Han-ZenX/CounterCode/hardware/C1804 频率测量模块 (REV04) - SCH.pdf

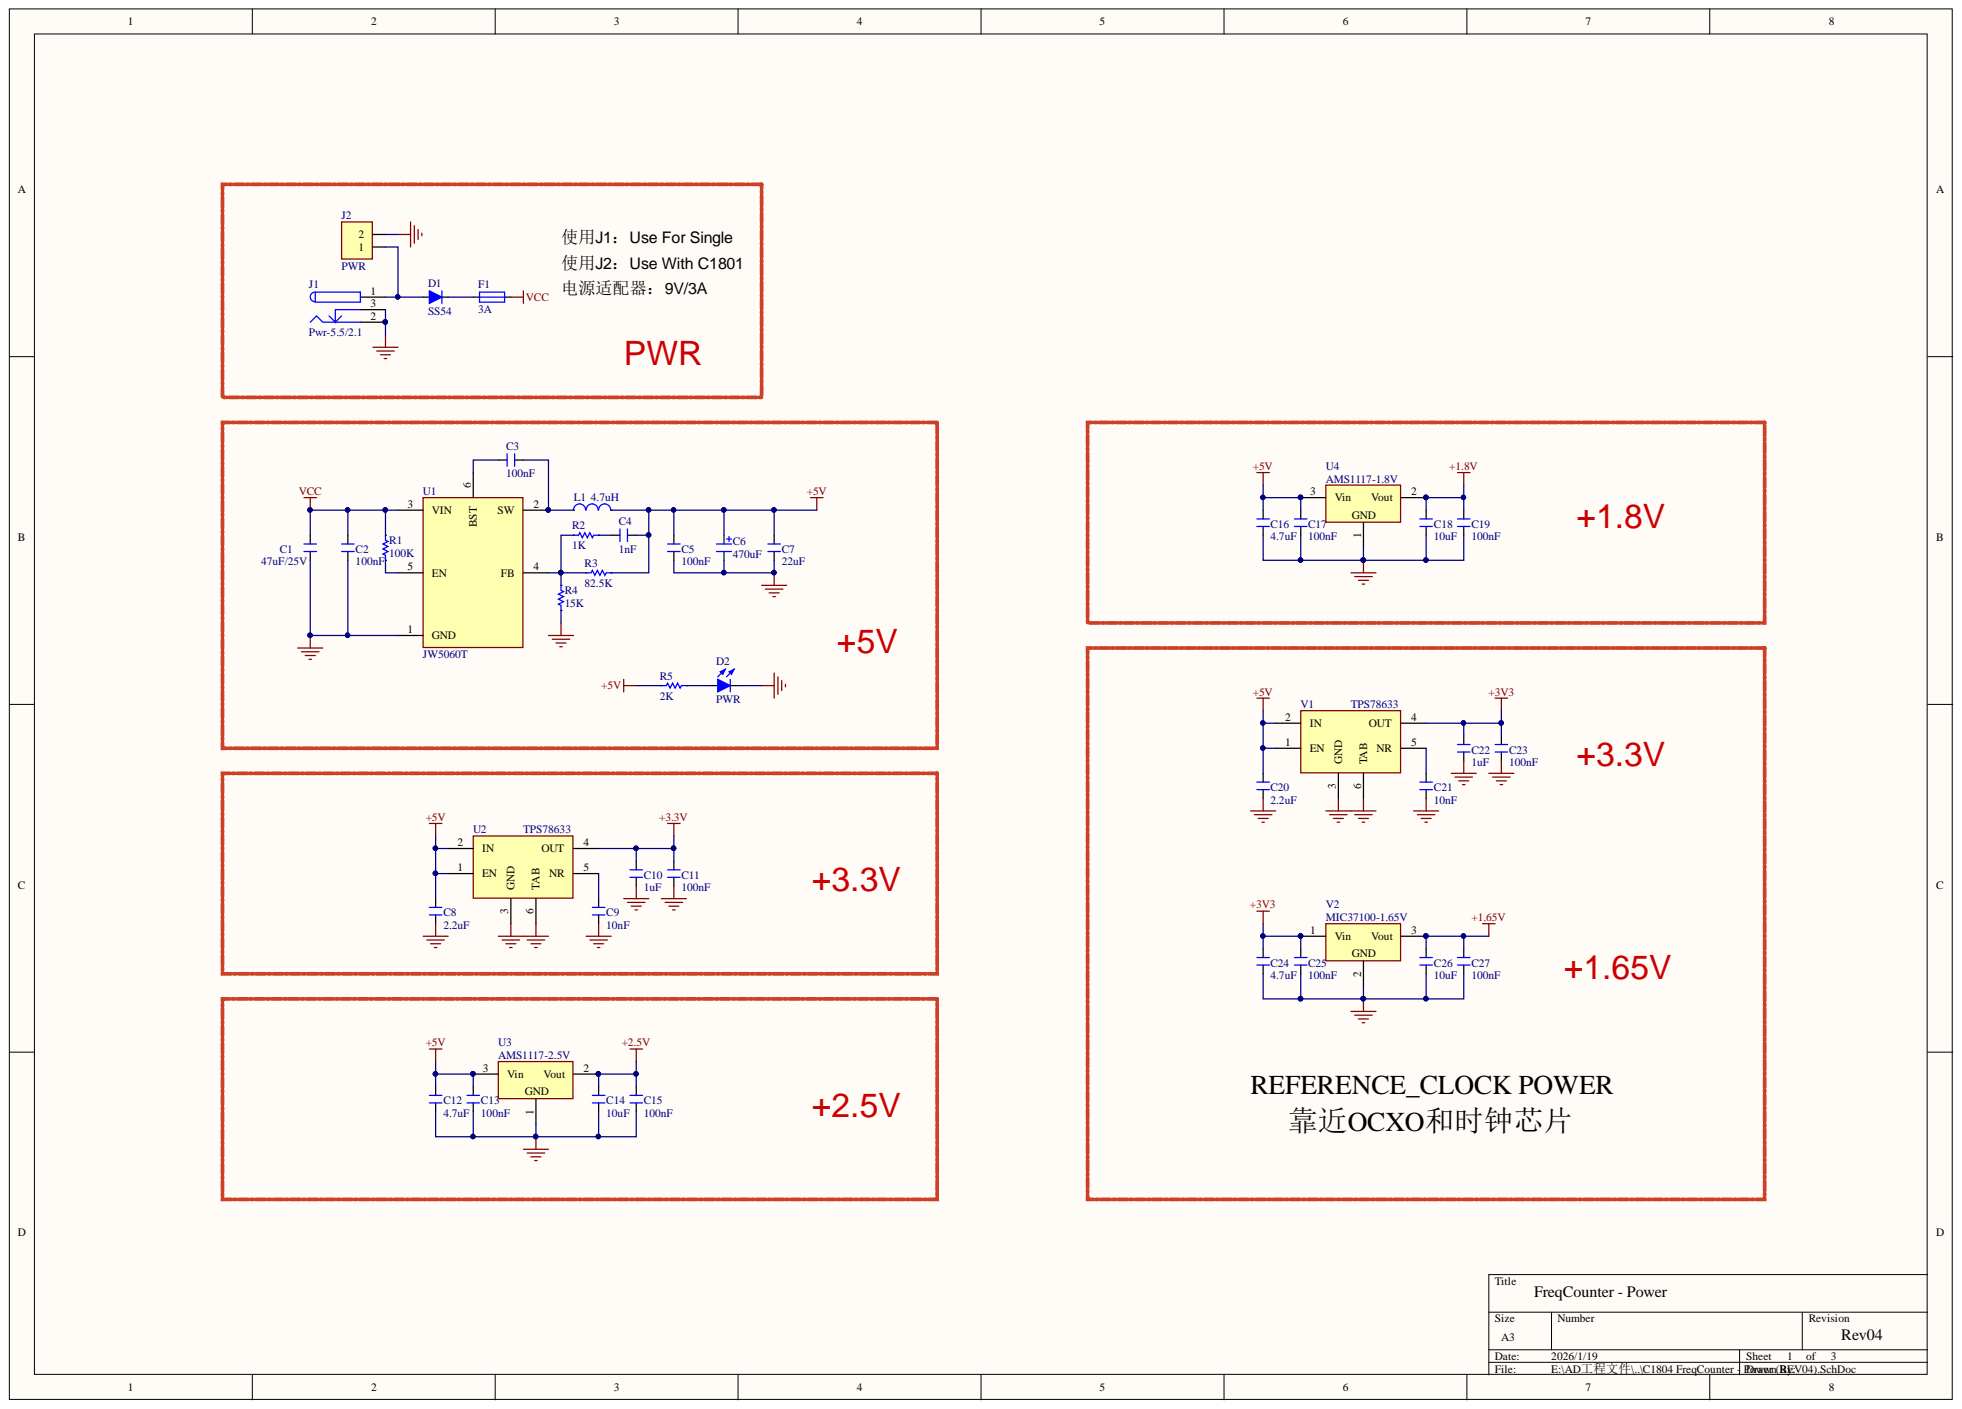
[picture p1: page 1]

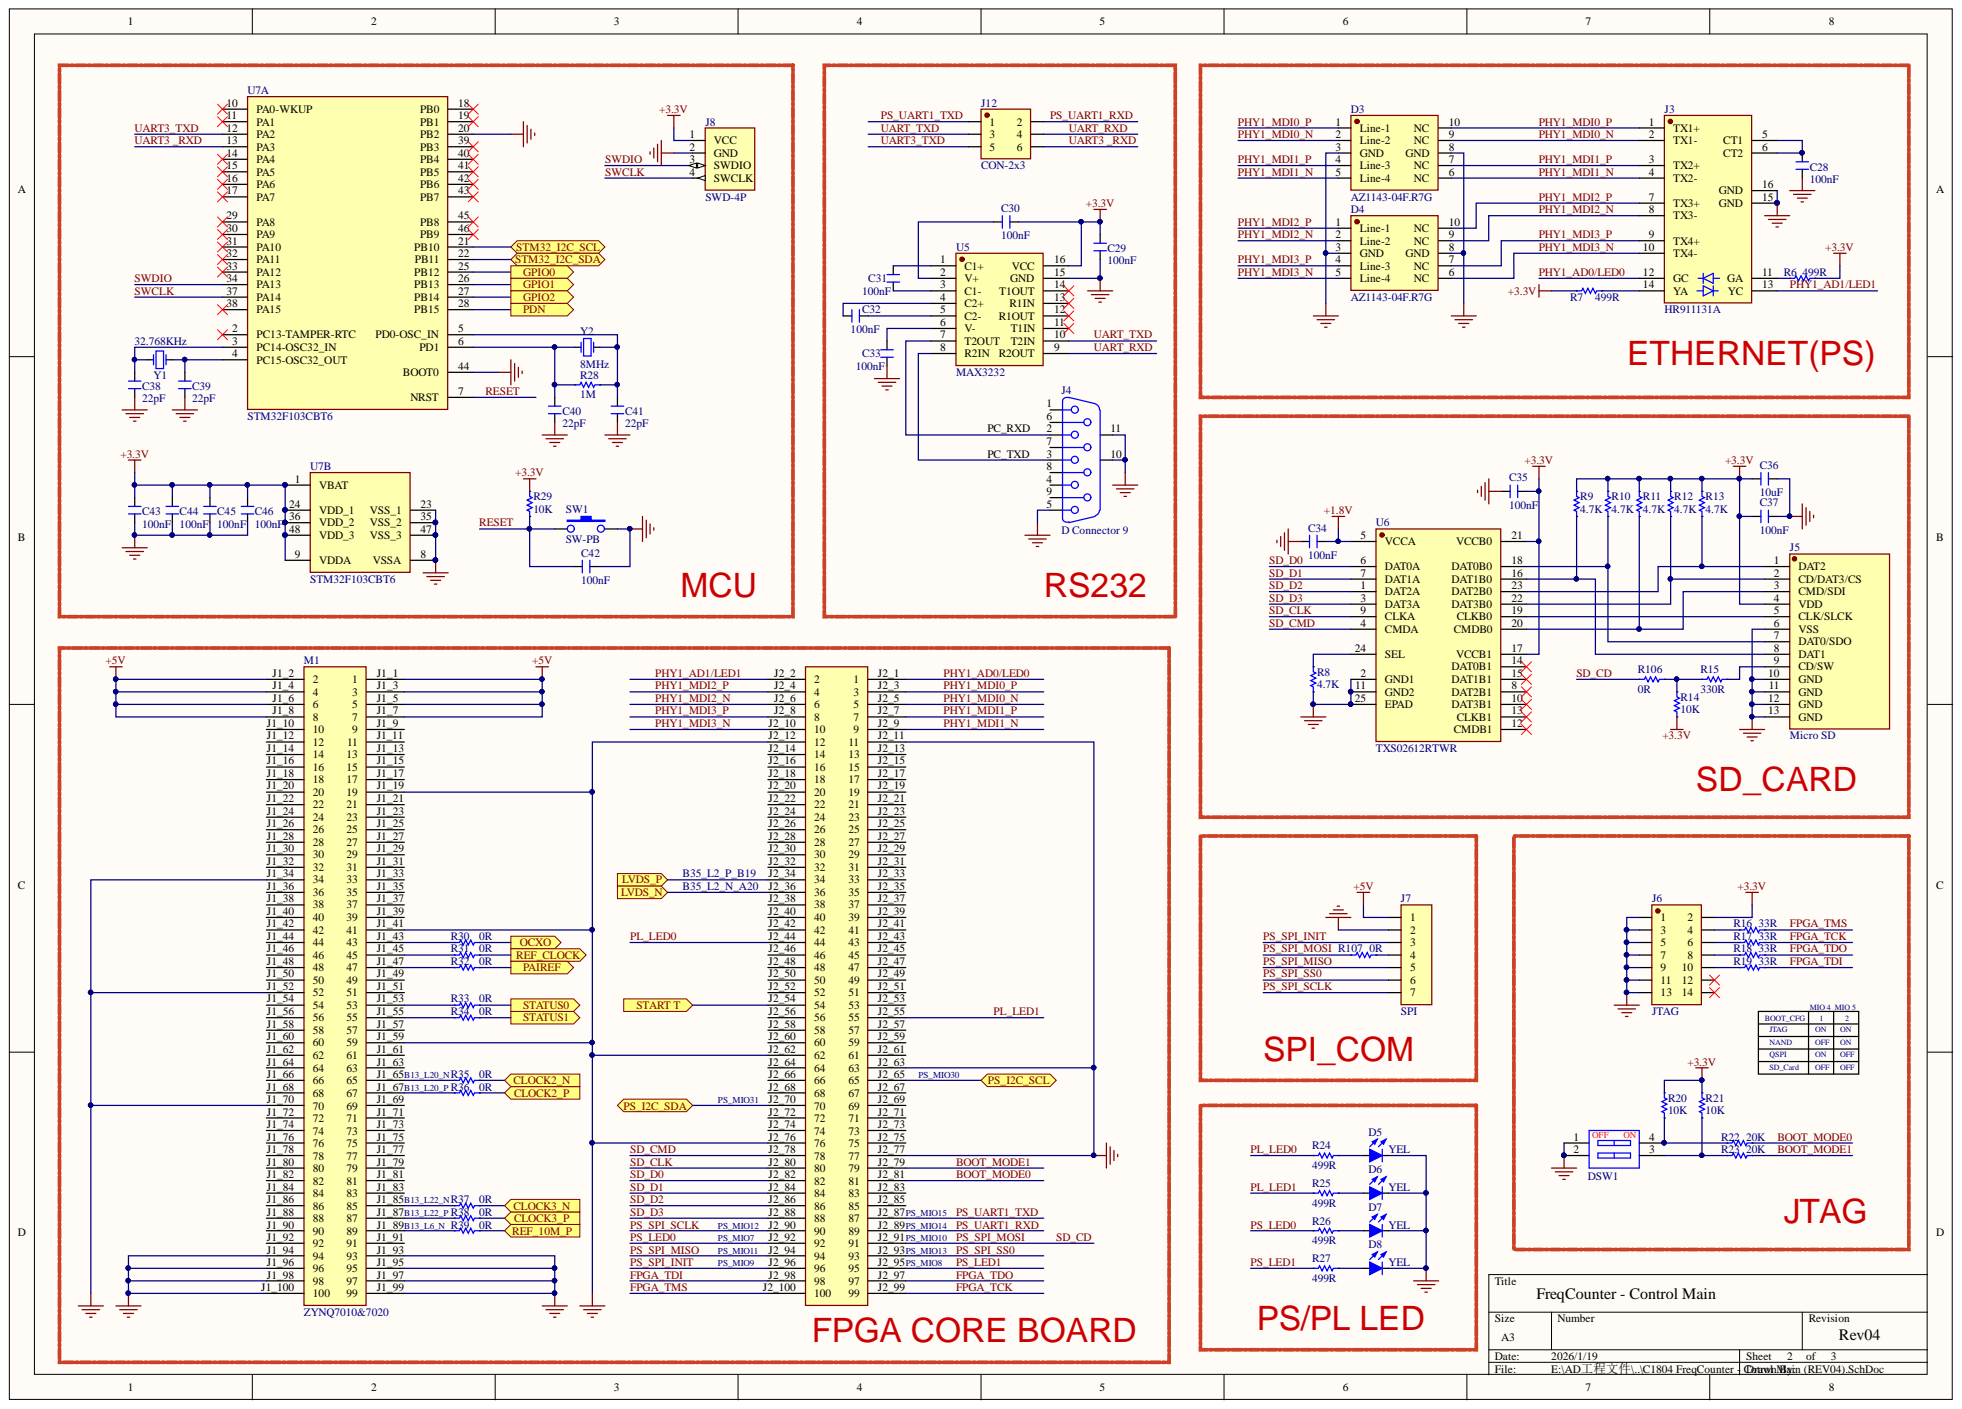
[picture p2: page 2]

VDD 4
CLK/SLCK 5
VSS 6
DAT0/SDO 7

JTAG | ON | ON
NAND | OFF | ON

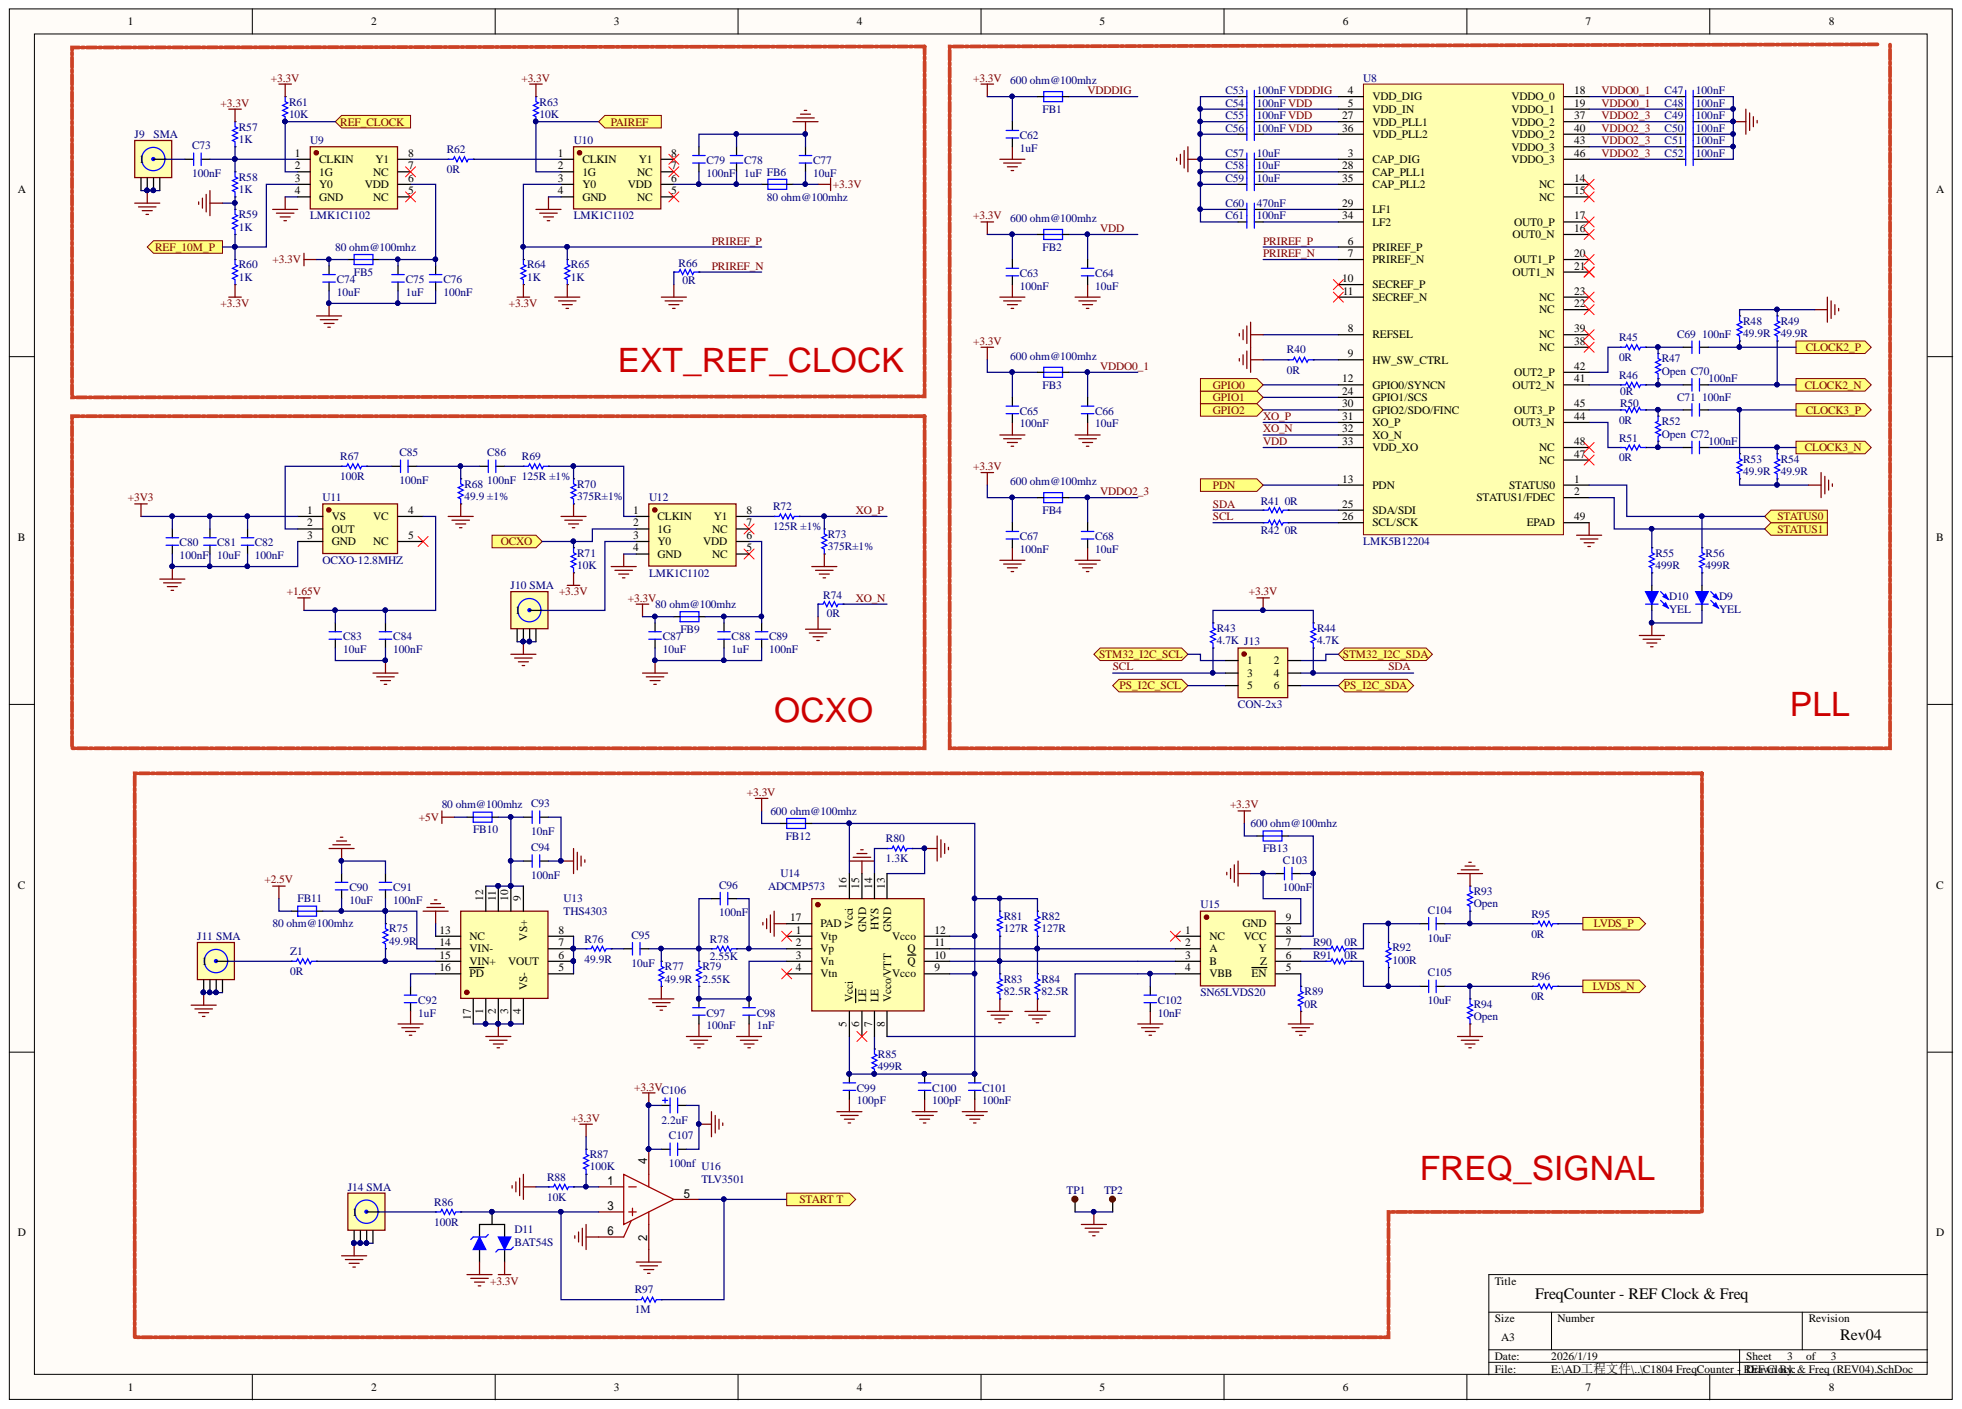
[picture p3: page 3]

SDA/SDI 25 | PLL

12 ND 13 HYS 14 GND 15 Vcci 16

Vcco/VTT 8 Vcco 9 Q 10 Q 11 Vcco G

Title
FreqCounter - REF Clock & Freq
