Han-ZenX/CounterCode/top_cymometer.sdk/FreqCounterOS/src/main.c

/*
 * Copyright (C) 2018 Xilinx, Inc.
 * All rights reserved.
 *
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
 */

#include <sleep.h>
#include "netif/xadapter.h"
#include "platform_config.h"
#include "xil_printf.h"
#include "xil_assert.h"
#include "uart/uart.h"
#include "Counter_Core.h"
#include "freq_counter_core/freq_counter_core.h"
#include "xparameters.h"
#include "ff.h"
#include <string.h>

#include "lwip/init.h"
#include "lwip/inet.h"

#if LWIP_IPV6==1
#include "lwip/ip6_addr.h"
#include "lwip/ip6.h"
#else

#if LWIP_DHCP==1
#include "lwip/dhcp.h"
extern volatile int dhcp_timoutcntr;
err_t dhcp_start(struct netif *netif);
#endif
#define DEFAULT_IP_ADDRESS "192.168.1.115"
#define DEFAULT_IP_MASK "255.255.255.0"
#define DEFAULT_GW_ADDRESS "192.168.1.1"
#define IP_CONFIG_FILE "0:/IPCFG.TXT"
#endif /* LWIP_IPV6 */

#ifdef XPS_BOARD_ZCU102
#ifdef XPAR_XIICPS_0_DEVICE_ID
int IicPhyReset(void);
#endif
#endif

static int complete_nw_thread;
static sys_thread_t main_thread_handle;

void print_app_header();
void start_application();

#define THREAD_STACKSIZE 1024

struct netif server_netif;

#if LWIP_IPV6==1
static void print_ipv6(char *msg, ip_addr_t *ip)
{
	print(msg);
	xil_printf(" %s\n\r", inet6_ntoa(*ip));
}
#else

static void print_ip(char *msg, ip_addr_t *ip)
{
	xil_printf(msg);
	xil_printf("%d.%d.%d.%d\n\r", ip4_addr1(ip), ip4_addr2(ip),
				ip4_addr3(ip), ip4_addr4(ip));
}

static void print_ip_settings(ip_addr_t *ip, ip_addr_t *mask, ip_addr_t *gw)
{
	print_ip("Board IP:       ", ip);
	print_ip("Netmask :       ", mask);
	print_ip("Gateway :       ", gw);
}

static void assign_default_ip(ip_addr_t *ip, ip_addr_t *mask, ip_addr_t *gw)
{
	int err;

	err = inet_aton(DEFAULT_IP_ADDRESS, ip);
	if(!err)
		xil_printf("Invalid default IP address: %d\r\n", err);

	err = inet_aton(DEFAULT_IP_MASK, mask);
	if(!err)
		xil_printf("Invalid default IP MASK: %d\r\n", err);

	err = inet_aton(DEFAULT_GW_ADDRESS, gw);
	if(!err)
		xil_printf("Invalid default gateway address: %d\r\n", err);
}

/*
 * Static IP configuration from the SD card.
 *
 * IPCFG.TXT in the card root holds one "KEY=VALUE" pair per line, keys IP,
 * MASK and GW. Blank lines and lines starting with '#' are ignored:
 *
 *     IP=192.168.1.115
 *     MASK=255.255.255.0
 *     GW=192.168.1.1
 *
 * Same card and same mount/unmount pattern as LoadClkFsFreq(), which has
 * already run by the time this is called.
 */
static char *trim_ws(char *s)
{
	char *e;

	while (*s == ' ' || *s == '\t')
		s++;

	e = s + strlen(s);
	while (e > s && (e[-1] == ' ' || e[-1] == '\t'))
		*--e = '\0';

	return s;
}

/*
 * Returns 0 when a usable IP address was read; the caller then keeps whatever
 * MASK and GW ended up in the outputs. Anything else returns non-zero and the
 * outputs must be treated as clobbered.
 *
 * fs, file and buf are static on purpose: FATFS and FIL each carry a 512-byte
 * sector buffer (FF_FS_TINY is 0), which is too much for the 4 KB task stack.
 */
static int load_ip_from_sd(ip_addr_t *ip, ip_addr_t *mask, ip_addr_t *gw)
{
	static FATFS fs;
	static FIL file;
	static char buf[512];
	FRESULT res;
	UINT br;
	char *p, *line, *eq, *key, *val;
	int have_ip = 0;

	res = f_mount(&fs, "0:", 1);
	if (res != FR_OK) {
		xil_printf("[NET] f_mount failed: %d\r\n", res);
		return -1;
	}

	res = f_open(&file, IP_CONFIG_FILE, FA_READ | FA_OPEN_EXISTING);
	if (res != FR_OK) {
		xil_printf("[NET] %s not found (err=%d)\r\n", IP_CONFIG_FILE, res);
		f_mount(NULL, "0:", 0);
		return -1;
	}

	memset(buf, 0, sizeof(buf));
	res = f_read(&file, buf, sizeof(buf) - 1, &br);
	f_close(&file);
	f_mount(NULL, "0:", 0);

	if (res != FR_OK || br == 0) {
		xil_printf("[NET] %s read failed (err=%d)\r\n", IP_CONFIG_FILE, res);
		return -1;
	}
	buf[br] = '\0';

	p = buf;
	while (*p) {
		line = p;
		while (*p && *p != '\r' && *p != '\n')
			p++;
		if (*p)
			*p++ = '\0';

		eq = strchr(line, '=');
		if (!eq)
			continue;
		*eq = '\0';

		key = trim_ws(line);
		val = trim_ws(eq + 1);
		if (key[0] == '#')
			continue;

		if (!strcmp(key, "IP")) {
			if (inet_aton(val, ip))
				have_ip = 1;
			else
				xil_printf("[NET] invalid IP in %s: %s\r\n", IP_CONFIG_FILE, val);
		} else if (!strcmp(key, "MASK")) {
			if (!inet_aton(val, mask))
				xil_printf("[NET] invalid MASK in %s: %s\r\n", IP_CONFIG_FILE, val);
		} else if (!strcmp(key, "GW")) {
			if (!inet_aton(val, gw))
				xil_printf("[NET] invalid GW in %s: %s\r\n", IP_CONFIG_FILE, val);
		}
	}

	return have_ip ? 0 : -1;
}

static void assign_ip(ip_addr_t *ip, ip_addr_t *mask, ip_addr_t *gw)
{
	/* Defaults first, so a file that only sets IP still gets a mask and a
	   gateway. A field the file sets badly keeps the default value. */
	assign_default_ip(ip, mask, gw);

	if (load_ip_from_sd(ip, mask, gw) == 0) {
		xil_printf("Configuring IP from %s\r\n", IP_CONFIG_FILE);
		return;
	}

	/* Partial results are discarded: the defaults are a consistent set,
	   a half-loaded one is not. */
	assign_default_ip(ip, mask, gw);
	xil_printf("Configuring default IP %s \r\n", DEFAULT_IP_ADDRESS);
}
#endif /* LWIP_IPV6 */

void network_thread(void *p)
{
#if ((LWIP_IPV6==0) && (LWIP_DHCP==1))
	int mscnt = 0;
#endif

	/* the mac address of the board. this should be unique per board */
	u8_t mac_ethernet_address[] = { 0x00, 0x0a, 0x35, 0x00, 0x01, 0x02 };

	xil_printf("\n\r\n\r");
	xil_printf("-----lwIP Socket Mode TCP Server Application------\r\n");

	/* Add network interface to the netif_list, and set it as default */
	if (!xemac_add(&server_netif, NULL, NULL, NULL, mac_ethernet_address,
		PLATFORM_EMAC_BASEADDR)) {
		xil_printf("Error adding N/W interface\r\n");
		return;
	}

#if LWIP_IPV6==1
	server_netif.ip6_autoconfig_enabled = 1;
	netif_create_ip6_linklocal_address(&server_netif, 1);
	netif_ip6_addr_set_state(&server_netif, 0, IP6_ADDR_VALID);
	print_ipv6("\n\rlink local IPv6 address is:",&server_netif.ip6_addr[0]);
#endif /* LWIP_IPV6 */

	netif_set_default(&server_netif);

	/* specify that the network if is up */
	netif_set_up(&server_netif);

	/* start packet receive thread - required for lwIP operation */
	sys_thread_new("xemacif_input_thread",
			(void(*)(void*))xemacif_input_thread, &server_netif,
			THREAD_STACKSIZE, DEFAULT_THREAD_PRIO);

	complete_nw_thread = 1;

	/* Resume the main thread; auto-negotiation is completed */
	vTaskResume(main_thread_handle);

#if ((LWIP_IPV6==0) && (LWIP_DHCP==1))
	dhcp_start(&server_netif);
	while (1) {
		vTaskDelay(DHCP_FINE_TIMER_MSECS / portTICK_RATE_MS);
		dhcp_fine_tmr();
		mscnt += DHCP_FINE_TIMER_MSECS;
		if (mscnt >= DHCP_COARSE_TIMER_SECS*1000) {
			dhcp_coarse_tmr();
			mscnt = 0;
		}
	}
#else
	vTaskDelete(NULL);
#endif
}

void main_thread(void *p)
{
#if ((LWIP_IPV6==0) && (LWIP_DHCP==1))
	int mscnt = 0;
#endif

#ifdef XPS_BOARD_ZCU102
	IicPhyReset();
#endif

	/* The counter comes up before the network: a missing cable or a failed
	   bind must not leave it uninitialised. A failure here is reported but
	   does not stop the network from coming up.

	   The serial port carries debug output only - SCPI runs over TCP alone,
	   and xil_printf writes the console UART directly, so no driver setup of
	   its own is needed here. */
	if (init_freqcounter() != 0)
		xil_printf("WARNING: frequency counter init failed\r\n");

	/* initialize lwIP before calling sys_thread_new */
	lwip_init();

	/* any thread using lwIP should be created using sys_thread_new */
	sys_thread_new("nw_thread", network_thread, NULL,
			THREAD_STACKSIZE, DEFAULT_THREAD_PRIO);

	/* Suspend Task until auto-negotiation is completed */
	if (!complete_nw_thread)
		vTaskSuspend(NULL);

#if LWIP_IPV6==0
#if LWIP_DHCP==1
	while (1) {
		vTaskDelay(DHCP_FINE_TIMER_MSECS / portTICK_RATE_MS);
		if (server_netif.ip_addr.addr) {
			xil_printf("DHCP request success\r\n");
			break;
		}
		mscnt += DHCP_FINE_TIMER_MSECS;
		if (mscnt >= 10000) {
			xil_printf("ERROR: DHCP request timed out\r\n");
			assign_ip(&(server_netif.ip_addr),
						&(server_netif.netmask),
						&(server_netif.gw));
			break;
		}
	}

#else
	assign_ip(&(server_netif.ip_addr), &(server_netif.netmask),
				&(server_netif.gw));
#endif

	print_ip_settings(&(server_netif.ip_addr), &(server_netif.netmask),
				&(server_netif.gw));
#endif /* LWIP_IPV6 */

	xil_printf("\r\n");

	/* print all application headers */
	print_app_header();
	xil_printf("\r\n");

	/* start the application*/
	start_application();

	vTaskDelete(NULL);
	return;
}

int main()
{
	/* Xil_Assert() ends in `while (Xil_AssertWait) {}`, so a failed driver
	   assertion parks the task that hit it forever. The PHY path does
	   exactly that with no cable attached: phy_setup_emacps() times out
	   after 30 s and hands XST_FAILURE to XEmacPs_SetOperatingSpeed(),
	   whose speed assertion then parks network_thread. main_thread stays
	   suspended, so the static IP is never applied and the TCP server never
	   starts - and it never recovers, because link_detect_thread needs the
	   netif state that xemac_add() had not finished writing. Report and
	   carry on instead of parking. */
	Xil_AssertWait = 0;

	main_thread_handle = sys_thread_new("main_thread", main_thread, 0,
			THREAD_STACKSIZE, DEFAULT_THREAD_PRIO);
	vTaskStartScheduler();
	while(1);
	return 0;
}
