Han-ZenX/CounterCode/ip_repo/top_cymometer_ip_1.6/hdl/top_cymometer_ip_v1_6_S0_AXI.v

`timescale 1 ns / 1 ps

	module top_cymometer_ip_v1_6_S0_AXI #
	(
		// Users to add parameters here

		// User parameters ends
		// Do not modify the parameters beyond this line

		// Width of S_AXI data bus
		parameter integer C_S_AXI_DATA_WIDTH	= 32,
		// Width of S_AXI address bus
		parameter integer C_S_AXI_ADDR_WIDTH	= 9
	)
	(
		// Users to add ports here
        input              clk_fx     ,         
        input              clk_fs     ,
		// User ports ends
		// Do not modify the ports beyond this line

		// Global Clock Signal
		input wire  S_AXI_ACLK,
		// Global Reset Signal. This Signal is Active LOW
		input wire  S_AXI_ARESETN,
		// Write address (issued by master, acceped by Slave)
		input wire [C_S_AXI_ADDR_WIDTH-1 : 0] S_AXI_AWADDR,
		// Write channel Protection type. This signal indicates the
    		// privilege and security level of the transaction, and whether
    		// the transaction is a data access or an instruction access.
		input wire [2 : 0] S_AXI_AWPROT,
		// Write address valid. This signal indicates that the master signaling
    		// valid write address and control information.
		input wire  S_AXI_AWVALID,
		// Write address ready. This signal indicates that the slave is ready
    		// to accept an address and associated control signals.
		output wire  S_AXI_AWREADY,
		// Write data (issued by master, acceped by Slave) 
		input wire [C_S_AXI_DATA_WIDTH-1 : 0] S_AXI_WDATA,
		// Write strobes. This signal indicates which byte lanes hold
    		// valid data. There is one write strobe bit for each eight
    		// bits of the write data bus.    
		input wire [(C_S_AXI_DATA_WIDTH/8)-1 : 0] S_AXI_WSTRB,
		// Write valid. This signal indicates that valid write
    		// data and strobes are available.
		input wire  S_AXI_WVALID,
		// Write ready. This signal indicates that the slave
    		// can accept the write data.
		output wire  S_AXI_WREADY,
		// Write response. This signal indicates the status
    		// of the write transaction.
		output wire [1 : 0] S_AXI_BRESP,
		// Write response valid. This signal indicates that the channel
    		// is signaling a valid write response.
		output wire  S_AXI_BVALID,
		// Response ready. This signal indicates that the master
    		// can accept a write response.
		input wire  S_AXI_BREADY,
		// Read address (issued by master, acceped by Slave)
		input wire [C_S_AXI_ADDR_WIDTH-1 : 0] S_AXI_ARADDR,
		// Protection type. This signal indicates the privilege
    		// and security level of the transaction, and whether the
    		// transaction is a data access or an instruction access.
		input wire [2 : 0] S_AXI_ARPROT,
		// Read address valid. This signal indicates that the channel
    		// is signaling valid read address and control information.
		input wire  S_AXI_ARVALID,
		// Read address ready. This signal indicates that the slave is
    		// ready to accept an address and associated control signals.
		output wire  S_AXI_ARREADY,
		// Read data (issued by slave)
		output wire [C_S_AXI_DATA_WIDTH-1 : 0] S_AXI_RDATA,
		// Read response. This signal indicates the status of the
    		// read transfer.
		output wire [1 : 0] S_AXI_RRESP,
		// Read valid. This signal indicates that the channel is
    		// signaling the required read data.
		output wire  S_AXI_RVALID,
		// Read ready. This signal indicates that the master can
    		// accept the read data and response information.
		input wire  S_AXI_RREADY
	);

	// AXI4LITE signals
	reg [C_S_AXI_ADDR_WIDTH-1 : 0] 	axi_awaddr;
	reg  	axi_awready;
	reg  	axi_wready;
	reg [1 : 0] 	axi_bresp;
	reg  	axi_bvalid;
	reg [C_S_AXI_ADDR_WIDTH-1 : 0] 	axi_araddr;
	reg  	axi_arready;
	reg [C_S_AXI_DATA_WIDTH-1 : 0] 	axi_rdata;
	reg [1 : 0] 	axi_rresp;
	reg  	axi_rvalid;

	// Example-specific design signals
	// local parameter for addressing 32 bit / 64 bit C_S_AXI_DATA_WIDTH
	// ADDR_LSB is used for addressing 32/64 bit registers/memories
	// ADDR_LSB = 2 for 32 bits (n downto 2)
	// ADDR_LSB = 3 for 64 bits (n downto 3)
	localparam integer ADDR_LSB = (C_S_AXI_DATA_WIDTH/32) + 1;
	localparam integer OPT_MEM_ADDR_BITS = 6;
	//----------------------------------------------
	//-- Signals for user logic register space example
	//------------------------------------------------
	//-- Number of Slave Registers 100
	reg [C_S_AXI_DATA_WIDTH-1:0]	slv_reg0;
	reg [C_S_AXI_DATA_WIDTH-1:0]	slv_reg1;
	reg [C_S_AXI_DATA_WIDTH-1:0]	slv_reg2;
	reg [C_S_AXI_DATA_WIDTH-1:0]	slv_reg3;
	reg [C_S_AXI_DATA_WIDTH-1:0]	slv_reg4;
	reg [C_S_AXI_DATA_WIDTH-1:0]	slv_reg5;
	reg [C_S_AXI_DATA_WIDTH-1:0]	slv_reg6;
	reg [C_S_AXI_DATA_WIDTH-1:0]	slv_reg7;
	reg [C_S_AXI_DATA_WIDTH-1:0]	slv_reg8;
	reg [C_S_AXI_DATA_WIDTH-1:0]	slv_reg9;
	reg [C_S_AXI_DATA_WIDTH-1:0]	slv_reg10;
	reg [C_S_AXI_DATA_WIDTH-1:0]	slv_reg11;
	reg [C_S_AXI_DATA_WIDTH-1:0]	slv_reg12;
	reg [C_S_AXI_DATA_WIDTH-1:0]	slv_reg13;
	reg [C_S_AXI_DATA_WIDTH-1:0]	slv_reg14;
	reg [C_S_AXI_DATA_WIDTH-1:0]	slv_reg15;
	reg [C_S_AXI_DATA_WIDTH-1:0]	slv_reg16;
	reg [C_S_AXI_DATA_WIDTH-1:0]	slv_reg17;
	reg [C_S_AXI_DATA_WIDTH-1:0]	slv_reg18;
	reg [C_S_AXI_DATA_WIDTH-1:0]	slv_reg19;
	reg [C_S_AXI_DATA_WIDTH-1:0]	slv_reg20;
	reg [C_S_AXI_DATA_WIDTH-1:0]	slv_reg21;
	reg [C_S_AXI_DATA_WIDTH-1:0]	slv_reg22;
	reg [C_S_AXI_DATA_WIDTH-1:0]	slv_reg23;
	reg [C_S_AXI_DATA_WIDTH-1:0]	slv_reg24;
	reg [C_S_AXI_DATA_WIDTH-1:0]	slv_reg25;
	reg [C_S_AXI_DATA_WIDTH-1:0]	slv_reg26;
	reg [C_S_AXI_DATA_WIDTH-1:0]	slv_reg27;
	reg [C_S_AXI_DATA_WIDTH-1:0]	slv_reg28;
	reg [C_S_AXI_DATA_WIDTH-1:0]	slv_reg29;
	reg [C_S_AXI_DATA_WIDTH-1:0]	slv_reg30;
	reg [C_S_AXI_DATA_WIDTH-1:0]	slv_reg31;
	reg [C_S_AXI_DATA_WIDTH-1:0]	slv_reg32;
	reg [C_S_AXI_DATA_WIDTH-1:0]	slv_reg33;
	reg [C_S_AXI_DATA_WIDTH-1:0]	slv_reg34;
	reg [C_S_AXI_DATA_WIDTH-1:0]	slv_reg35;
	reg [C_S_AXI_DATA_WIDTH-1:0]	slv_reg36;
	reg [C_S_AXI_DATA_WIDTH-1:0]	slv_reg37;
	reg [C_S_AXI_DATA_WIDTH-1:0]	slv_reg38;
	reg [C_S_AXI_DATA_WIDTH-1:0]	slv_reg39;
	reg [C_S_AXI_DATA_WIDTH-1:0]	slv_reg40;
	reg [C_S_AXI_DATA_WIDTH-1:0]	slv_reg41;
	reg [C_S_AXI_DATA_WIDTH-1:0]	slv_reg42;
	reg [C_S_AXI_DATA_WIDTH-1:0]	slv_reg43;
	reg [C_S_AXI_DATA_WIDTH-1:0]	slv_reg44;
	reg [C_S_AXI_DATA_WIDTH-1:0]	slv_reg45;
	reg [C_S_AXI_DATA_WIDTH-1:0]	slv_reg46;
	reg [C_S_AXI_DATA_WIDTH-1:0]	slv_reg47;
	reg [C_S_AXI_DATA_WIDTH-1:0]	slv_reg48;
	reg [C_S_AXI_DATA_WIDTH-1:0]	slv_reg49;
	reg [C_S_AXI_DATA_WIDTH-1:0]	slv_reg50;
	reg [C_S_AXI_DATA_WIDTH-1:0]	slv_reg51;
	reg [C_S_AXI_DATA_WIDTH-1:0]	slv_reg52;
	reg [C_S_AXI_DATA_WIDTH-1:0]	slv_reg53;
	reg [C_S_AXI_DATA_WIDTH-1:0]	slv_reg54;
	reg [C_S_AXI_DATA_WIDTH-1:0]	slv_reg55;
	reg [C_S_AXI_DATA_WIDTH-1:0]	slv_reg56;
	reg [C_S_AXI_DATA_WIDTH-1:0]	slv_reg57;
	reg [C_S_AXI_DATA_WIDTH-1:0]	slv_reg58;
	reg [C_S_AXI_DATA_WIDTH-1:0]	slv_reg59;
	reg [C_S_AXI_DATA_WIDTH-1:0]	slv_reg60;
	reg [C_S_AXI_DATA_WIDTH-1:0]	slv_reg61;
	reg [C_S_AXI_DATA_WIDTH-1:0]	slv_reg62;
	reg [C_S_AXI_DATA_WIDTH-1:0]	slv_reg63;
	reg [C_S_AXI_DATA_WIDTH-1:0]	slv_reg64;
	reg [C_S_AXI_DATA_WIDTH-1:0]	slv_reg65;
	reg [C_S_AXI_DATA_WIDTH-1:0]	slv_reg66;
	reg [C_S_AXI_DATA_WIDTH-1:0]	slv_reg67;
	reg [C_S_AXI_DATA_WIDTH-1:0]	slv_reg68;
	reg [C_S_AXI_DATA_WIDTH-1:0]	slv_reg69;
	reg [C_S_AXI_DATA_WIDTH-1:0]	slv_reg70;
	reg [C_S_AXI_DATA_WIDTH-1:0]	slv_reg71;
	reg [C_S_AXI_DATA_WIDTH-1:0]	slv_reg72;
	reg [C_S_AXI_DATA_WIDTH-1:0]	slv_reg73;
	reg [C_S_AXI_DATA_WIDTH-1:0]	slv_reg74;
	reg [C_S_AXI_DATA_WIDTH-1:0]	slv_reg75;
	reg [C_S_AXI_DATA_WIDTH-1:0]	slv_reg76;
	reg [C_S_AXI_DATA_WIDTH-1:0]	slv_reg77;
	reg [C_S_AXI_DATA_WIDTH-1:0]	slv_reg78;
	reg [C_S_AXI_DATA_WIDTH-1:0]	slv_reg79;
	reg [C_S_AXI_DATA_WIDTH-1:0]	slv_reg80;
	reg [C_S_AXI_DATA_WIDTH-1:0]	slv_reg81;
	reg [C_S_AXI_DATA_WIDTH-1:0]	slv_reg82;
	reg [C_S_AXI_DATA_WIDTH-1:0]	slv_reg83;
	reg [C_S_AXI_DATA_WIDTH-1:0]	slv_reg84;
	reg [C_S_AXI_DATA_WIDTH-1:0]	slv_reg85;
	reg [C_S_AXI_DATA_WIDTH-1:0]	slv_reg86;
	reg [C_S_AXI_DATA_WIDTH-1:0]	slv_reg87;
	reg [C_S_AXI_DATA_WIDTH-1:0]	slv_reg88;
	reg [C_S_AXI_DATA_WIDTH-1:0]	slv_reg89;
	reg [C_S_AXI_DATA_WIDTH-1:0]	slv_reg90;
	reg [C_S_AXI_DATA_WIDTH-1:0]	slv_reg91;
	reg [C_S_AXI_DATA_WIDTH-1:0]	slv_reg92;
	reg [C_S_AXI_DATA_WIDTH-1:0]	slv_reg93;
	reg [C_S_AXI_DATA_WIDTH-1:0]	slv_reg94;
	reg [C_S_AXI_DATA_WIDTH-1:0]	slv_reg95;
	reg [C_S_AXI_DATA_WIDTH-1:0]	slv_reg96;
	reg [C_S_AXI_DATA_WIDTH-1:0]	slv_reg97;
	reg [C_S_AXI_DATA_WIDTH-1:0]	slv_reg98;
	reg [C_S_AXI_DATA_WIDTH-1:0]	slv_reg99;
	wire	 slv_reg_rden;
	wire	 slv_reg_wren;
	reg [C_S_AXI_DATA_WIDTH-1:0]	 reg_data_out;
	integer	 byte_index;
	reg	 aw_en;
	
	//Add User Registers
	wire [C_S_AXI_DATA_WIDTH-1:0]	cnt_clk_stand_reg;
	wire [C_S_AXI_DATA_WIDTH-1:0]	cnt_clk_test_reg;
	
	wire [C_S_AXI_DATA_WIDTH-1:0]	tdc_ref_rise;
	wire [C_S_AXI_DATA_WIDTH-1:0]	tdc_ref_fall;
	wire [C_S_AXI_DATA_WIDTH-1:0]	tdc_test_rise;
	wire [C_S_AXI_DATA_WIDTH-1:0]	tdc_test_fall;

	wire [1:0]		ts_mode;
	wire [31:0]		edge_skip;
	wire [10:0]		ts_fifo_count;
	wire			ts_fifo_full;
	wire [31:0]		ts_fifo_data_cnt;
	wire [5:0]		ts_fifo_data_tdc;
	wire [9:0]		ts_fifo_rd_addr;

	assign ts_mode         = slv_reg23[1:0];
	assign edge_skip       = slv_reg24;
	assign ts_fifo_rd_addr = slv_reg26[9:0];

	// I/O Connections assignments

	assign S_AXI_AWREADY	= axi_awready;
	assign S_AXI_WREADY	= axi_wready;
	assign S_AXI_BRESP	= axi_bresp;
	assign S_AXI_BVALID	= axi_bvalid;
	assign S_AXI_ARREADY	= axi_arready;
	assign S_AXI_RDATA	= axi_rdata;
	assign S_AXI_RRESP	= axi_rresp;
	assign S_AXI_RVALID	= axi_rvalid;
	// Implement axi_awready generation
	// axi_awready is asserted for one S_AXI_ACLK clock cycle when both
	// S_AXI_AWVALID and S_AXI_WVALID are asserted. axi_awready is
	// de-asserted when reset is low.

	always @( posedge S_AXI_ACLK )
	begin
	  if ( S_AXI_ARESETN == 1'b0 )
	    begin
	      axi_awready <= 1'b0;
	      aw_en <= 1'b1;
	    end 
	  else
	    begin    
	      if (~axi_awready && S_AXI_AWVALID && S_AXI_WVALID && aw_en)
	        begin
	          // slave is ready to accept write address when 
	          // there is a valid write address and write data
	          // on the write address and data bus. This design 
	          // expects no outstanding transactions. 
	          axi_awready <= 1'b1;
	          aw_en <= 1'b0;
	        end
	        else if (S_AXI_BREADY && axi_bvalid)
	            begin
	              aw_en <= 1'b1;
	              axi_awready <= 1'b0;
	            end
	      else           
	        begin
	          axi_awready <= 1'b0;
	        end
	    end 
	end       

	// Implement axi_awaddr latching
	// This process is used to latch the address when both 
	// S_AXI_AWVALID and S_AXI_WVALID are valid. 

	always @( posedge S_AXI_ACLK )
	begin
	  if ( S_AXI_ARESETN == 1'b0 )
	    begin
	      axi_awaddr <= 0;
	    end 
	  else
	    begin    
	      if (~axi_awready && S_AXI_AWVALID && S_AXI_WVALID && aw_en)
	        begin
	          // Write Address latching 
	          axi_awaddr <= S_AXI_AWADDR;
	        end
	    end 
	end       

	// Implement axi_wready generation
	// axi_wready is asserted for one S_AXI_ACLK clock cycle when both
	// S_AXI_AWVALID and S_AXI_WVALID are asserted. axi_wready is 
	// de-asserted when reset is low. 

	always @( posedge S_AXI_ACLK )
	begin
	  if ( S_AXI_ARESETN == 1'b0 )
	    begin
	      axi_wready <= 1'b0;
	    end 
	  else
	    begin    
	      if (~axi_wready && S_AXI_WVALID && S_AXI_AWVALID && aw_en )
	        begin
	          // slave is ready to accept write data when 
	          // there is a valid write address and write data
	          // on the write address and data bus. This design 
	          // expects no outstanding transactions. 
	          axi_wready <= 1'b1;
	        end
	      else
	        begin
	          axi_wready <= 1'b0;
	        end
	    end 
	end       

	// Implement memory mapped register select and write logic generation
	// The write data is accepted and written to memory mapped registers when
	// axi_awready, S_AXI_WVALID, axi_wready and S_AXI_WVALID are asserted. Write strobes are used to
	// select byte enables of slave registers while writing.
	// These registers are cleared when reset (active low) is applied.
	// Slave register write enable is asserted when valid address and data are available
	// and the slave is ready to accept the write address and write data.
	assign slv_reg_wren = axi_wready && S_AXI_WVALID && axi_awready && S_AXI_AWVALID;

	always @( posedge S_AXI_ACLK )
	begin
	  if ( S_AXI_ARESETN == 1'b0 )
	    begin
	      slv_reg0 <= 0;
	      slv_reg1 <= 0;
	      slv_reg2 <= 0;
	      slv_reg3 <= 0;
	      slv_reg4 <= 0;
	      slv_reg5 <= 0;
	      slv_reg6 <= 0;
	      slv_reg7 <= 0;
	      slv_reg8 <= 0;
	      slv_reg9 <= 0;
	      slv_reg10 <= 0;
	      slv_reg11 <= 0;
	      slv_reg12 <= 0;
	      slv_reg13 <= 0;
	      slv_reg14 <= 0;
	      slv_reg15 <= 0;
	      slv_reg16 <= 0;
	      slv_reg17 <= 0;
	      slv_reg18 <= 0;
	      slv_reg19 <= 0;
	      slv_reg20 <= 0;
	      slv_reg21 <= 0;
	      slv_reg22 <= 0;
	      slv_reg23 <= 0;
	      slv_reg24 <= 0;
	      slv_reg25 <= 0;
	      slv_reg26 <= 0;
	      slv_reg27 <= 0;
	      slv_reg28 <= 0;
	      slv_reg29 <= 0;
	      slv_reg30 <= 0;
	      slv_reg31 <= 0;
	      slv_reg32 <= 0;
	      slv_reg33 <= 0;
	      slv_reg34 <= 0;
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
	                      slv_reg78 <= slv_reg78;
	                      slv_reg79 <= slv_reg79;
	                      slv_reg80 <= slv_reg80;
	                      slv_reg81 <= slv_reg81;
	                      slv_reg82 <= slv_reg82;
	                      slv_reg83 <= slv_reg83;
	                      slv_reg84 <= slv_reg84;
	                      slv_reg85 <= slv_reg85;
	                      slv_reg86 <= slv_reg86;
	                      slv_reg87 <= slv_reg87;
	                      slv_reg88 <= slv_reg88;
	                      slv_reg89 <= slv_reg89;
	                      slv_reg90 <= slv_reg90;
	                      slv_reg91 <= slv_reg91;
	                      slv_reg92 <= slv_reg92;
	                      slv_reg93 <= slv_reg93;
	                      slv_reg94 <= slv_reg94;
	                      slv_reg95 <= slv_reg95;
	                      slv_reg96 <= slv_reg96;
	                      slv_reg97 <= slv_reg97;
	                      slv_reg98 <= slv_reg98;
	                      slv_reg99 <= slv_reg99;
	                    end
	        endcase
	      end
	  end
	end    

	// Implement write response logic generation
	// The write response and response valid signals are asserted by the slave
     top_cymometer u_top_cymometer(
        .clk_fx     (clk_fx),
        .clk_fs     (clk_fs),
        
        .cnt_clk_stand_reg (cnt_clk_stand_reg),
        .cnt_clk_test_reg (cnt_clk_test_reg),
        
        .reset_sig (slv_reg13[0]),
        .gate_sig (slv_reg14[0]),
        
        .tdc_ref_rise (tdc_ref_rise[7:0]),
        .tdc_ref_fall (tdc_ref_fall[7:0]),
        .tdc_test_rise (tdc_test_rise[7:0]),
        .tdc_test_fall (tdc_test_fall[7:0]),
        .s_axi_aclk      (S_AXI_ACLK),
        .ts_mode         (ts_mode),
        .edge_skip       (edge_skip),
        .ts_fifo_count   (ts_fifo_count),
        .ts_fifo_full    (ts_fifo_full),
        .ts_fifo_data_cnt(ts_fifo_data_cnt),
        .ts_fifo_data_tdc(ts_fifo_data_tdc),
        .ts_fifo_rd_addr (ts_fifo_rd_addr)
    ); 
	// when axi_wready, S_AXI_WVALID, axi_wready and S_AXI_WVALID are asserted.  
	// This marks the acceptance of address and indicates the status of 
	// write transaction.

	always @( posedge S_AXI_ACLK )
	begin
	  if ( S_AXI_ARESETN == 1'b0 )
	    begin
	      axi_bvalid  <= 0;
	      axi_bresp   <= 2'b0;
	    end 
	  else
	    begin    
	      if (axi_awready && S_AXI_AWVALID && ~axi_bvalid && axi_wready && S_AXI_WVALID)
	        begin
	          // indicates a valid write response is available
	          axi_bvalid <= 1'b1;
	          axi_bresp  <= 2'b0; // 'OKAY' response 
	        end                   // work error responses in future
	      else
	        begin
	          if (S_AXI_BREADY && axi_bvalid) 
	            //check if bready is asserted while bvalid is high) 
	            //(there is a possibility that bready is always asserted high)   
	            begin
	              axi_bvalid <= 1'b0; 
	            end  
	        end
	    end
	end   

	// Implement axi_arready generation
	// axi_arready is asserted for one S_AXI_ACLK clock cycle when
	// S_AXI_ARVALID is asserted. axi_awready is 
	// de-asserted when reset (active low) is asserted. 
	// The read address is also latched when S_AXI_ARVALID is 
	// asserted. axi_araddr is reset to zero on reset assertion.

	always @( posedge S_AXI_ACLK )
	begin
	  if ( S_AXI_ARESETN == 1'b0 )
	    begin
	      axi_arready <= 1'b0;
	      axi_araddr  <= 32'b0;
	    end 
	  else
	    begin    
	      if (~axi_arready && S_AXI_ARVALID)
	        begin
	          // indicates that the slave has acceped the valid read address
	          axi_arready <= 1'b1;
	          // Read address latching
	          axi_araddr  <= S_AXI_ARADDR;
	        end
	      else
	        begin
	          axi_arready <= 1'b0;
	        end
	    end 
	end       

	// Implement axi_arvalid generation
	// axi_rvalid is asserted for one S_AXI_ACLK clock cycle when both 
	// S_AXI_ARVALID and axi_arready are asserted. The slave registers 
	// data are available on the axi_rdata bus at this instance. The 
	// assertion of axi_rvalid marks the validity of read data on the 
	// bus and axi_rresp indicates the status of read transaction.axi_rvalid 
	// is deasserted on reset (active low). axi_rresp and axi_rdata are 
	// cleared to zero on reset (active low).  
	always @( posedge S_AXI_ACLK )
	begin
	  if ( S_AXI_ARESETN == 1'b0 )
	    begin
	      axi_rvalid <= 0;
	      axi_rresp  <= 0;
	    end 
	  else
	    begin    
	      if (axi_arready && S_AXI_ARVALID && ~axi_rvalid)
	        begin
	          // Valid read data is available at the read data bus
	          axi_rvalid <= 1'b1;
	          axi_rresp  <= 2'b0; // 'OKAY' response
	        end   
	      else if (axi_rvalid && S_AXI_RREADY)
	        begin
	          // Read data is accepted by the master
	          axi_rvalid <= 1'b0;
	        end                
	    end
	end    

	// Implement memory mapped register select and read logic generation
	// Slave register read enable is asserted when valid address is available
	// and the slave is ready to accept the read address.
	assign slv_reg_rden = axi_arready & S_AXI_ARVALID & ~axi_rvalid;
	always @(*)
	begin
	      // Address decoding for reading registers
	      case ( axi_araddr[ADDR_LSB+OPT_MEM_ADDR_BITS:ADDR_LSB] )
	        7'h00   : reg_data_out <= slv_reg0;
	        7'h01   : reg_data_out <= slv_reg1;
	        7'h02   : reg_data_out <= slv_reg2;
	        7'h03   : reg_data_out <= slv_reg3;
	        7'h04   : reg_data_out <= slv_reg4;
	        7'h05   : reg_data_out <= slv_reg5;
	        7'h06   : reg_data_out <= slv_reg6;
	        7'h07   : reg_data_out <= slv_reg7;
	        7'h08   : reg_data_out <= slv_reg8;
	        7'h09   : reg_data_out <= slv_reg9;
	        7'h0A   : reg_data_out <= slv_reg10;
	        7'h0B   : reg_data_out <= slv_reg11;
	        7'h0C   : reg_data_out <= slv_reg12;
	        7'h0D   : reg_data_out <= slv_reg13;
	        7'h0E   : reg_data_out <= slv_reg14;
	        7'h0F   : reg_data_out <= slv_reg15;
	        7'h10   : reg_data_out <= cnt_clk_stand_reg;
	        7'h11   : reg_data_out <= cnt_clk_test_reg;
	        7'h12   : reg_data_out <= slv_reg18;
	        7'h13   : reg_data_out <= tdc_ref_rise;   // REG19: TDC基准域上升沿
	        7'h14   : reg_data_out <= tdc_ref_fall;   // REG20: TDC基准域下降沿
	        7'h15   : reg_data_out <= tdc_test_rise;  // REG21: TDC被测域上升沿
	        7'h16   : reg_data_out <= tdc_test_fall;  // REG22: TDC被测域下降沿
	        7'h17   : reg_data_out <= slv_reg23;
	        7'h18   : reg_data_out <= slv_reg24;
	        7'h19   : reg_data_out <= {21'b0, ts_fifo_full, ts_fifo_count};
	        7'h1A   : reg_data_out <= slv_reg26;
	        7'h1B   : reg_data_out <= ts_fifo_data_cnt;
	        7'h1C   : reg_data_out <= {26'b0, ts_fifo_data_tdc};
	        7'h1D   : reg_data_out <= slv_reg29;
	        7'h1E   : reg_data_out <= slv_reg30;
	        7'h1F   : reg_data_out <= slv_reg31;
	        7'h20   : reg_data_out <= slv_reg32;
	        7'h21   : reg_data_out <= slv_reg33;
	        7'h22   : reg_data_out <= slv_reg34;
	        7'h23   : reg_data_out <= slv_reg35;
	        7'h24   : reg_data_out <= slv_reg36;
	        7'h25   : reg_data_out <= slv_reg37;
	        7'h26   : reg_data_out <= slv_reg38;
	        7'h27   : reg_data_out <= slv_reg39;
	        7'h28   : reg_data_out <= slv_reg40;
	        7'h29   : reg_data_out <= slv_reg41;
	        7'h2A   : reg_data_out <= slv_reg42;
	        7'h2B   : reg_data_out <= slv_reg43;
	        7'h2C   : reg_data_out <= slv_reg44;
	        7'h2D   : reg_data_out <= slv_reg45;
	        7'h2E   : reg_data_out <= slv_reg46;
	        7'h2F   : reg_data_out <= slv_reg47;
	        7'h30   : reg_data_out <= slv_reg48;
	        7'h31   : reg_data_out <= slv_reg49;
	        7'h32   : reg_data_out <= slv_reg50;
	        7'h33   : reg_data_out <= slv_reg51;
	        7'h34   : reg_data_out <= slv_reg52;
	        7'h35   : reg_data_out <= slv_reg53;
	        7'h36   : reg_data_out <= slv_reg54;
	        7'h37   : reg_data_out <= slv_reg55;
	        7'h38   : reg_data_out <= slv_reg56;
	        7'h39   : reg_data_out <= slv_reg57;
	        7'h3A   : reg_data_out <= slv_reg58;
	        7'h3B   : reg_data_out <= slv_reg59;
	        7'h3C   : reg_data_out <= slv_reg60;
	        7'h3D   : reg_data_out <= slv_reg61;
	        7'h3E   : reg_data_out <= slv_reg62;
	        7'h3F   : reg_data_out <= slv_reg63;
	        7'h40   : reg_data_out <= slv_reg64;
	        7'h41   : reg_data_out <= slv_reg65;
	        7'h42   : reg_data_out <= slv_reg66;
	        7'h43   : reg_data_out <= slv_reg67;
	        7'h44   : reg_data_out <= slv_reg68;
	        7'h45   : reg_data_out <= slv_reg69;
	        7'h46   : reg_data_out <= slv_reg70;
	        7'h47   : reg_data_out <= slv_reg71;
	        7'h48   : reg_data_out <= slv_reg72;
	        7'h49   : reg_data_out <= slv_reg73;
	        7'h4A   : reg_data_out <= slv_reg74;
	        7'h4B   : reg_data_out <= slv_reg75;
	        7'h4C   : reg_data_out <= slv_reg76;
	        7'h4D   : reg_data_out <= slv_reg77;
	        7'h4E   : reg_data_out <= slv_reg78;
	        7'h4F   : reg_data_out <= slv_reg79;
	        7'h50   : reg_data_out <= slv_reg80;
	        7'h51   : reg_data_out <= slv_reg81;
	        7'h52   : reg_data_out <= slv_reg82;
	        7'h53   : reg_data_out <= slv_reg83;
	        7'h54   : reg_data_out <= slv_reg84;
	        7'h55   : reg_data_out <= slv_reg85;
	        7'h56   : reg_data_out <= slv_reg86;
	        7'h57   : reg_data_out <= slv_reg87;
	        7'h58   : reg_data_out <= slv_reg88;
	        7'h59   : reg_data_out <= slv_reg89;
	        7'h5A   : reg_data_out <= slv_reg90;
	        7'h5B   : reg_data_out <= slv_reg91;
	        7'h5C   : reg_data_out <= slv_reg92;
	        7'h5D   : reg_data_out <= slv_reg93;
	        7'h5E   : reg_data_out <= slv_reg94;
	        7'h5F   : reg_data_out <= slv_reg95;
	        7'h60   : reg_data_out <= slv_reg96;
	        7'h61   : reg_data_out <= slv_reg97;
	        7'h62   : reg_data_out <= slv_reg98;
	        7'h63   : reg_data_out <= slv_reg99;
	        default : reg_data_out <= 0;
	      endcase
	end

	// Output register or memory read data
	always @( posedge S_AXI_ACLK )
	begin
	  if ( S_AXI_ARESETN == 1'b0 )
	    begin
	      axi_rdata  <= 0;
	    end 
	  else
	    begin    
	      // When there is a valid read address (S_AXI_ARVALID) with 
	      // acceptance of read address by the slave (axi_arready), 
	      // output the read dada 
	      if (slv_reg_rden)
	        begin
	          axi_rdata <= reg_data_out;     // register read data
	        end   
	    end
	end    

	// Add user logic here

	// User logic ends

	endmodule
