Han-ZenX/CounterCode/top_cymometer.srcs/sources_1/ip/top_cymometer_ip_v1.0/ip_repo/top_cymometer_ip_1.0/hdl/top_cymometer/lcd_rgb_char/lcd_driver.v

module lcd_driver(
    input                lcd_pclk,    //时钟
    input                rst_n,       //复位，低电平有效
    input        [15:0]  lcd_id,      //LCD屏ID
    input        [23:0]  pixel_data,  //像素数据
    output  reg  [10:0]  pixel_xpos,  //当前像素点横坐标
    output  reg  [10:0]  pixel_ypos,  //当前像素点纵坐标   

    //RGB LCD接口
    output  reg          lcd_de,      //LCD 数据使能信号
    output               lcd_hs,      //LCD 行同步信号
    output               lcd_vs,      //LCD 场同步信号
    output               lcd_bl,      //LCD 背光控制信号
    output               lcd_clk,     //LCD 像素时钟
    output               lcd_rst,     //LCD复位
    output       [23:0]  lcd_rgb      //LCD RGB888颜色数据
    );

//parameter define  
// 4.3' 480*272
parameter  H_SYNC_4342   =  11'd41;     //行同步
parameter  H_BACK_4342   =  11'd2;      //行显示后沿
parameter  H_DISP_4342   =  11'd480;    //行有效数据
parameter  H_FRONT_4342  =  11'd2;      //行显示前沿
parameter  H_TOTAL_4342  =  11'd525;    //行扫描周期
   
parameter  V_SYNC_4342   =  11'd10;     //场同步
parameter  V_BACK_4342   =  11'd2;      //场显示后沿
parameter  V_DISP_4342   =  11'd272;    //场有效数据
parameter  V_FRONT_4342  =  11'd2;      //场显示前沿
parameter  V_TOTAL_4342  =  11'd286;    //场扫描周期
   
// 7' 800*480   
parameter  H_SYNC_7084   =  11'd128;    //行同步
parameter  H_BACK_7084   =  11'd88;     //行显示后沿
parameter  H_DISP_7084   =  11'd800;    //行有效数据
parameter  H_FRONT_7084  =  11'd40;     //行显示前沿
parameter  H_TOTAL_7084  =  11'd1056;   //行扫描周期
   
parameter  V_SYNC_7084   =  11'd2;      //场同步
parameter  V_BACK_7084   =  11'd33;     //场显示后沿
parameter  V_DISP_7084   =  11'd480;    //场有效数据
parameter  V_FRONT_7084  =  11'd10;     //场显示前沿
parameter  V_TOTAL_7084  =  11'd525;    //场扫描周期       
   
// 7' 1024*600   
parameter  H_SYNC_7016   =  11'd20;     //行同步
parameter  H_BACK_7016   =  11'd140;    //行显示后沿
parameter  H_DISP_7016   =  11'd1024;   //行有效数据
parameter  H_FRONT_7016  =  11'd160;    //行显示前沿
parameter  H_TOTAL_7016  =  11'd1344;   //行扫描周期
   
parameter  V_SYNC_7016   =  11'd3;      //场同步
parameter  V_BACK_7016   =  11'd20;     //场显示后沿
parameter  V_DISP_7016   =  11'd600;    //场有效数据
parameter  V_FRONT_7016  =  11'd12;     //场显示前沿
parameter  V_TOTAL_7016  =  11'd635;    //场扫描周期
   
// 10.1' 1280*800   
parameter  H_SYNC_1018   =  11'd10;     //行同步
parameter  H_BACK_1018   =  11'd80;     //行显示后沿
parameter  H_DISP_1018   =  11'd1280;   //行有效数据
parameter  H_FRONT_1018  =  11'd70;     //行显示前沿
parameter  H_TOTAL_1018  =  11'd1440;   //行扫描周期
   
parameter  V_SYNC_1018   =  11'd3;      //场同步
parameter  V_BACK_1018   =  11'd10;     //场显示后沿
parameter  V_DISP_1018   =  11'd800;    //场有效数据
parameter  V_FRONT_1018  =  11'd10;     //场显示前沿
parameter  V_TOTAL_1018  =  11'd823;    //场扫描周期

// 4.3' 800*480   
parameter  H_SYNC_4384   =  11'd128;    //行同步
parameter  H_BACK_4384   =  11'd88;     //行显示后沿
parameter  H_DISP_4384   =  11'd800;    //行有效数据
parameter  H_FRONT_4384  =  11'd40;     //行显示前沿
parameter  H_TOTAL_4384  =  11'd1056;   //行扫描周期
   
parameter  V_SYNC_4384   =  11'd2;      //场同步
parameter  V_BACK_4384   =  11'd33;     //场显示后沿
parameter  V_DISP_4384   =  11'd480;    //场有效数据
parameter  V_FRONT_4384  =  11'd10;     //场显示前沿
parameter  V_TOTAL_4384  =  11'd525;    //场扫描周期    

//reg define
reg  [10:0] h_sync ;
reg  [10:0] h_back ;
reg  [10:0] h_total;
reg  [10:0] v_sync ;
reg  [10:0] v_back ;
reg  [10:0] v_total;
reg  [10:0] h_cnt  ;
reg  [10:0] v_cnt  ;
reg  [10:0]  h_disp;      //LCD屏水平分辨率
reg  [10:0]  v_disp;      //LCD屏垂直分辨率 
reg          data_req;    //数据请求信号

//*****************************************************
//**                    main code
//*****************************************************

//RGB LCD 采用DE模式时，行场同步信号需要拉高
assign  lcd_hs = 1'b1;        //LCD行同步信号
assign  lcd_vs = 1'b1;        //LCD场同步信号

assign  lcd_bl = 1'b1;        //LCD背光控制信号  
assign  lcd_clk = lcd_pclk;   //LCD像素时钟
assign  lcd_rst= 1'b1;        //LCD复位

//RGB888数据输出
assign lcd_rgb = lcd_de ? pixel_data : 24'd0;

always@ (posedge lcd_pclk or negedge rst_n) begin
    if(!rst_n)
        pixel_xpos <= 11'd0;
    else if(data_req)
        pixel_xpos <= h_cnt + 2'd2 - h_sync - h_back ;
    else 
        pixel_xpos <= 11'd0;
end
       
always@ (posedge lcd_pclk or negedge rst_n) begin
    if(!rst_n)
        pixel_ypos <= 11'd0;
    else if(v_cnt >= (v_sync + v_back)&&v_cnt < (v_sync + v_back + v_disp))
        pixel_ypos <= v_cnt + 1'b1 - (v_sync + v_back) ;
    else 
        pixel_ypos <= 11'd0;
end

//行场时序参数
always @(*) begin
    case(lcd_id)
        16'h4342 : begin
            h_sync  = H_SYNC_4342; 
            h_back  = H_BACK_4342; 
            h_disp  = H_DISP_4342; 
            h_total = H_TOTAL_4342;
            v_sync  = V_SYNC_4342; 
            v_back  = V_BACK_4342; 
            v_disp  = V_DISP_4342; 
            v_total = V_TOTAL_4342;            
        end
        16'h7084 : begin
            h_sync  = H_SYNC_7084; 
            h_back  = H_BACK_7084; 
            h_disp  = H_DISP_7084; 
            h_total = H_TOTAL_7084;
            v_sync  = V_SYNC_7084; 
            v_back  = V_BACK_7084; 
            v_disp  = V_DISP_7084; 
            v_total = V_TOTAL_7084;        
        end
        16'h7016 : begin
            h_sync  = H_SYNC_7016; 
            h_back  = H_BACK_7016; 
            h_disp  = H_DISP_7016; 
            h_total = H_TOTAL_7016;
            v_sync  = V_SYNC_7016; 
            v_back  = V_BACK_7016; 
            v_disp  = V_DISP_7016; 
            v_total = V_TOTAL_7016;            
        end
        16'h4384 : begin
            h_sync  = H_SYNC_4384; 
            h_back  = H_BACK_4384; 
            h_disp  = H_DISP_4384; 
            h_total = H_TOTAL_4384;
            v_sync  = V_SYNC_4384; 
            v_back  = V_BACK_4384; 
            v_disp  = V_DISP_4384; 
            v_total = V_TOTAL_4384;             
        end        
        16'h1018 : begin
            h_sync  = H_SYNC_1018; 
            h_back  = H_BACK_1018; 
            h_disp  = H_DISP_1018; 
            h_total = H_TOTAL_1018;
            v_sync  = V_SYNC_1018; 
            v_back  = V_BACK_1018; 
            v_disp  = V_DISP_1018; 
            v_total = V_TOTAL_1018;        
        end
        default : begin
            h_sync  = H_SYNC_4342; 
            h_back  = H_BACK_4342; 
            h_disp  = H_DISP_4342; 
            h_total = H_TOTAL_4342;
            v_sync  = V_SYNC_4342; 
            v_back  = V_BACK_4342; 
            v_disp  = V_DISP_4342; 
            v_total = V_TOTAL_4342;          
        end
    endcase
end
	
//数据使能信号		
always@ (posedge lcd_pclk or negedge rst_n) begin
    if(!rst_n)	
		lcd_de <= 1'b0;
	else
		lcd_de <= data_req;
end
				  
//请求像素点颜色数据输入  
always@ (posedge lcd_pclk or negedge rst_n) begin
    if(!rst_n)	
		data_req<=1'b0;
	else if((h_cnt >= h_sync + h_back - 2'd2) && (h_cnt < h_sync + h_back + h_disp - 2'd2)
             && (v_cnt >= v_sync + v_back) && (v_cnt < v_sync + v_back + v_disp))
		data_req <= 1'b1;
	else
		data_req <= 1'b0;
end
				  
//行计数器对像素时钟计数
always@ (posedge lcd_pclk or negedge rst_n) begin
    if(!rst_n) 
        h_cnt <= 11'd0;
    else begin
        if(h_cnt == h_total - 1'b1)
            h_cnt <= 11'd0;
        else
            h_cnt <= h_cnt + 1'b1;           
    end
end

//场计数器对行计数
always@ (posedge lcd_pclk or negedge rst_n) begin
    if(!rst_n) 
        v_cnt <= 11'd0;
    else begin
        if(h_cnt == h_total - 1'b1) begin
            if(v_cnt == v_total - 1'b1)
                v_cnt <= 11'd0;
            else
                v_cnt <= v_cnt + 1'b1;    
        end
    end    
end

endmodule
