Han-ZenX/CounterCode/top_cymometer.srcs/sources_1/ip/top_cymometer_ip_v1.0/ip_repo/top_cymometer_ip_1.0/hdl/top_cymometer/top_cymometer.v

module top_cymometer#(
    //parameter define
    parameter       DIV_N        = 26'd10_000_000   ,   // 分频系数
    parameter       CHAR_POS_X   = 11'd1            ,   // 字符区域起始点横坐标
    parameter       CHAR_POS_Y   = 11'd1            ,   // 字符区域起始点纵坐标
    parameter       CHAR_WIDTH   = 11'd88           ,   // 字符区域宽度
    parameter       CHAR_HEIGHT  = 11'd16           ,   // 字符区域高度
    parameter       WHITE        = 24'hFFFFFF       ,   // 背景色，白色
    parameter       BLACK        = 24'h0            ,   // 字符颜色，黑色
    parameter       CNT_GATE_MAX = 28'd25_000_000   ,   // 测频周期时间为0.5s  
    parameter       CNT_GATE_LOW = 28'd1_500_000   ,   // 闸门为低的时间0.03s
    parameter       CNT_TIME_MAX = 28'd26_000_000   ,   // 测频周期时间为0.52s
    parameter       CLK_FS_FREQ  = 28'd200_000_000  ,
    parameter       DATAWIDTH    = 8'd57
)(
    input              sys_clk    ,             // 时钟信号
    input              sys_rst_n  ,             // 复位信号
    input              clk_fx     ,             // 被测时钟
    input              clk_fs     ,             //基准时钟

	output             lcd_hs     ,             // LCD 行同步信号
	output             lcd_vs     ,             // LCD 场同步信号
	output             lcd_de     ,             // LCD 数据输入使能
	inout      [23:0]  lcd_rgb    ,             // LCD RGB颜色数据
	output             lcd_bl     ,             // LCD 背光控制信号
	output             lcd_clk    ,             // LCD 采样时钟
    output             lcd_rst
);
//wire define
wire    [31:0]       data_fx;        // 被测信号测量值       
//wire                 clk_fs;

wire        en;             

wire [56:0] dividend;       
wire [56:0] divisor;        

wire        ready;          
wire [56:0] quotient;       
wire [56:0] remainder;     
wire        vld_out;        

//*****************************************************
//**                    main code
//*****************************************************

// 产生基准时钟100M

//例化等精度频率计模块 
cymometer#(
    .CNT_GATE_MAX   (CNT_GATE_MAX),      // 测频周期时间为1.5s  
    .CNT_GATE_LOW   (CNT_GATE_LOW),      // 闸门为低的时间0.25s
    .CNT_TIME_MAX   (CNT_TIME_MAX),
    .CLK_FS_FREQ    (CLK_FS_FREQ )
)
u_cymometer(
    .sys_clk        (sys_clk    ),       // 系统时钟，50M
    .clk_fs         (clk_fs     ),       // 基准时钟，200M
    .sys_rst_n      (sys_rst_n  ),       // 系统复位，低电平有效
    .clk_fx         (clk_fx     ),       // 被测时钟信号
    .data_fx        (data_fx    ),       // 被测时钟频率值
    .dividend       (dividend   ),       
    .divisor        (divisor    ),       
    .en             (en         ),    
    .ready          (ready      ),       
    .quotient       (quotient   ),       
    .remainder      (remainder  ),       
    .vld_out        (vld_out    )        
    
);

//除法器模块
div_fsm
#(
    .DATAWIDTH      (DATAWIDTH  )
)
u_div_fsm(
    .clk            (sys_clk    ),      
    .rst_n          (sys_rst_n  ),      
    .en             (en         ),      

    .dividend       (dividend   ),      
    .divisor        (divisor    ),      

    .ready          (ready      ),      
    .quotient       (quotient   ),      
    .remainder      (remainder  ),      
    .vld_out        (vld_out    )       
);

//例化测试时钟模块，产生测试时钟
/*
clk_test 
#(
    .DIV_N          (DIV_N      )
)
u_clk_test(
    .clk_in         (sys_clk    ),
    .rst_n          (sys_rst_n  ),
    .clk_out        (clk_out1    )
);*/

//例化LCD显示模块
lcd_rgb_char 
#(
    .CHAR_POS_X     (CHAR_POS_X ),
    .CHAR_POS_Y     (CHAR_POS_Y ),
    .CHAR_WIDTH     (CHAR_WIDTH ),
    .CHAR_HEIGHT    (CHAR_HEIGHT),
    .WHITE          (WHITE      ),
    .BLACK          (BLACK      )
)
u_lcd_rgb_char(
    .sys_clk        (sys_clk    ),
    .sys_rst_n      (sys_rst_n  ),
    .data           (data_fx    ),     
    .lcd_hs         (lcd_hs     ),          // LCD 行同步信号
    .lcd_vs         (lcd_vs     ),          // LCD 场同步信号
    .lcd_de         (lcd_de     ),          // LCD 数据输入使能
    .lcd_rgb        (lcd_rgb    ),          // LCD RGB888颜色数据
    .lcd_bl         (lcd_bl     ),          // LCD 背光控制信号
    .lcd_clk        (lcd_clk    ),          // LCD 采样时钟
    .lcd_rst        (lcd_rst    )
);

endmodule
