Han-ZenX/CounterCode/ip_repo/top_cymometer_ip_1.6/hdl/top_cymometer_ip_v1_6.v

`timescale 1 ns / 1 ps

	module top_cymometer_ip_v1_6 #
	(
		// Users to add parameters here

		// User parameters ends
		// Do not modify the parameters beyond this line


		// Parameters of Axi Slave Bus Interface S0_AXI
		parameter integer C_S0_AXI_DATA_WIDTH	= 32,
		parameter integer C_S0_AXI_ADDR_WIDTH	= 9
	)
	(
		// Users to add ports here
        input              clk_fx_p     ,             //被测时钟p
        input              clk_fx_n     ,             //被测时钟n
        input              clk_fs_p     ,             //基准时钟p
        input              clk_fs_n     ,             //基准时钟n
		// User ports ends
		// Do not modify the ports beyond this line


		// Ports of Axi Slave Bus Interface S0_AXI
		input wire  s0_axi_aclk,
		input wire  s0_axi_aresetn,
		input wire [C_S0_AXI_ADDR_WIDTH-1 : 0] s0_axi_awaddr,
		input wire [2 : 0] s0_axi_awprot,
		input wire  s0_axi_awvalid,
		output wire  s0_axi_awready,
		input wire [C_S0_AXI_DATA_WIDTH-1 : 0] s0_axi_wdata,
		input wire [(C_S0_AXI_DATA_WIDTH/8)-1 : 0] s0_axi_wstrb,
		input wire  s0_axi_wvalid,
		output wire  s0_axi_wready,
		output wire [1 : 0] s0_axi_bresp,
		output wire  s0_axi_bvalid,
		input wire  s0_axi_bready,
		input wire [C_S0_AXI_ADDR_WIDTH-1 : 0] s0_axi_araddr,
		input wire [2 : 0] s0_axi_arprot,
		input wire  s0_axi_arvalid,
		output wire  s0_axi_arready,
		output wire [C_S0_AXI_DATA_WIDTH-1 : 0] s0_axi_rdata,
		output wire [1 : 0] s0_axi_rresp,
		output wire  s0_axi_rvalid,
		input wire  s0_axi_rready
	);
	
	wire    clk_fx;
    wire    clk_fx_O;
    
	wire    clk_fs;
    wire    clk_312_5m;
    
    IBUFDS #(
    .DIFF_TERM("FALSE"),
    .IBUF_LOW_PWR("FALSE"),
    .IOSTANDARD  ("LVDS_25")
    ) signal_in_diff(
        .O(clk_312_5m),
        .I(clk_fs_p),
        .IB(clk_fs_n)
    );
    
    BUFG BUFG_inst(
        .O(clk_fs),
        .I(clk_312_5m)
    );
    
    IBUFDS #(
    .DIFF_TERM("TRUE"),
    .IBUF_LOW_PWR("FALSE"),
    .IOSTANDARD  ("LVDS_25")
    ) signal_in_diff1(
        .O(clk_fx_O),
        .I(clk_fx_p),
        .IB(clk_fx_n)
    );
    
    BUFG BUFG_inst1(
        .O(clk_fx),
        .I(clk_fx_O)
    );
    
// Instantiation of Axi Bus Interface S0_AXI
	top_cymometer_ip_v1_6_S0_AXI # ( 
		.C_S_AXI_DATA_WIDTH(C_S0_AXI_DATA_WIDTH),
		.C_S_AXI_ADDR_WIDTH(C_S0_AXI_ADDR_WIDTH)
	) top_cymometer_ip_v1_6_S0_AXI_inst (
		.S_AXI_ACLK(s0_axi_aclk),
		.S_AXI_ARESETN(s0_axi_aresetn),
		.S_AXI_AWADDR(s0_axi_awaddr),
		.S_AXI_AWPROT(s0_axi_awprot),
		.S_AXI_AWVALID(s0_axi_awvalid),
		.S_AXI_AWREADY(s0_axi_awready),
		.S_AXI_WDATA(s0_axi_wdata),
		.S_AXI_WSTRB(s0_axi_wstrb),
		.S_AXI_WVALID(s0_axi_wvalid),
		.S_AXI_WREADY(s0_axi_wready),
		.S_AXI_BRESP(s0_axi_bresp),
		.S_AXI_BVALID(s0_axi_bvalid),
		.S_AXI_BREADY(s0_axi_bready),
		.S_AXI_ARADDR(s0_axi_araddr),
		.S_AXI_ARPROT(s0_axi_arprot),
		.S_AXI_ARVALID(s0_axi_arvalid),
		.S_AXI_ARREADY(s0_axi_arready),
		.S_AXI_RDATA(s0_axi_rdata),
		.S_AXI_RRESP(s0_axi_rresp),
		.S_AXI_RVALID(s0_axi_rvalid),
		.S_AXI_RREADY(s0_axi_rready),
		
		.clk_fx     (clk_fx),
		.clk_fs     (clk_fs)
	);

	// Add user logic here

	// User logic ends

	endmodule
