Han-ZenX/CounterCode/top_cymometer.srcs/constrs_1/new/top_cymometer.xdc

#=============================================================================
# Timing constraints
#
# Previously this file had no create_clock for clk_fs / clk_fx at all. The
# check_timing report showed 270 register pins driven by clk_fs_p and 119 by
# clk_fx_p with NO CLOCK DEFINED -- meaning the TDC, the counters and the
# timestamp engine were almost entirely outside timing analysis. Any WNS
# figure quoted before this was only about the AXI logic.
#=============================================================================

#-----------------------------------------------------------------------------
# Reference clock: 312.5 MHz LVDS differential input
#-----------------------------------------------------------------------------
create_clock -period 3.200 -name clk_fs [get_ports clk_fs_p]

#-----------------------------------------------------------------------------
# Signal under test
#
# The frequency depends on what is being measured, so constrain for the
# fastest input the instrument is meant to handle -- the clk_fx domain logic
# (equal-precision counter, test-domain TDC, gate synchroniser) must close at
# that worst case. 350 MHz has been exercised on hardware.
#
# If timing does not close here, that is a real result, not a nuisance: it
# means the 32-bit counter or the TDC sampling cannot keep up at 350 MHz and
# the usable upper limit is lower than assumed. Relax the period only after
# deciding the instrument will not be used that fast.
#-----------------------------------------------------------------------------
create_clock -period 2.857 -name clk_fx [get_ports clk_fx_p]

#-----------------------------------------------------------------------------
# External 10 MHz reference
#
# Nothing in the design is clocked by this pin -- counter_core's source mux
# hands it to the TDC delay chain and the clk_fs sampler as data, so it needs
# no BUFG. It is still declared as a clock so the crossing into clk_fs is
# covered by the asynchronous clock group below; leaving it undeclared would
# put the whole path outside timing analysis, which is exactly the hole this
# file was written to close for clk_fs and clk_fx.
#-----------------------------------------------------------------------------
create_clock -period 100.000 -name clk_10m [get_ports clk_10m]

#-----------------------------------------------------------------------------
# Clock groups
#
# The three domains are mutually asynchronous. Every crossing inside
# Counter_Core goes through an explicit synchroniser (rst_sync / bit_sync /
# cnt_cdc), which is exactly what "asynchronous" declares. Without this the
# tool tries to time every CDC path against unrelated clocks and buries the
# real violations under thousands of meaningless ones.
#
# If clk_fpga_0 is not the name in this project, run
#     report_clocks
# and substitute the actual name of the PS FCLK_CLK0 output.
#-----------------------------------------------------------------------------
set_clock_groups -asynchronous \
    -group [get_clocks -include_generated_clocks clk_fs] \
    -group [get_clocks -include_generated_clocks clk_fx] \
    -group [get_clocks -include_generated_clocks clk_10m] \
    -group [get_clocks -include_generated_clocks clk_fpga_0]

#-----------------------------------------------------------------------------
# TDC delay chain
#
# tap_reg samples a CARRY4 chain fed by an asynchronous signal. Capturing
# where a transition sits *inside* a clock period is the entire purpose, so
# this path is deliberately not meant to meet setup/hold and must be excluded
# -- otherwise it reports failures that cannot and should not be fixed.
#
# Note this only silences the analysis, it says nothing about uniformity.
#
# The earlier note here blamed the measured 133 ps/tap on CARRY4 blocks being
# spread out, and prescribed manual LOC/RLOC placement. That diagnosis was
# wrong. The chain used to cascade on CO[0], which is an ordinary combinational
# output routed through general interconnect -- that routing was the 133 ps.
# Only CO[3] drives the dedicated COUT pin. Now that tdc.v cascades on CO[3],
# the connection is COUT -> CIN of the slice directly above, which is hard
# wired, so the placer has no freedom left: the blocks must already sit in one
# continuous column.
#
# LOC therefore buys little delay-wise. Its remaining value is repeatability --
# pinning the chain so two implementation runs are comparable. Because the
# cascade is vertical and forced, pinning stage 0 is enough to pin all 16.
# Measure first (TdcHistogramTest) and only pin if runs disagree.
#
# set_property LOC SLICE_X0Y0 [get_cells \
#     ps_i/Counter_Core_0/inst/u_ts_engine/u_tdc/delay_stage[0].carry4_inst]
#-----------------------------------------------------------------------------
set_false_path -to [get_pins -hier -filter {NAME =~ *tdc*/tap_reg_reg*/D}]

#=============================================================================
# Pin assignments
#=============================================================================

#-----------------------------------------------------------------------------
# Reference clock clk_fs
#
# CLOCK_DEDICATED_ROUTE FALSE is required because the clock enters on a
# regular IO pin rather than a dedicated clock-capable pin.
#-----------------------------------------------------------------------------
set_property CLOCK_DEDICATED_ROUTE FALSE [get_nets ps_i/Counter_Core_0/inst/clk_fs_ibuf]
set_property PACKAGE_PIN Y12 [get_ports clk_fs_p]
set_property IOSTANDARD LVDS_25 [get_ports clk_fs_p]

#-----------------------------------------------------------------------------
# Signal under test clk_fx
#-----------------------------------------------------------------------------
set_property CLOCK_DEDICATED_ROUTE FALSE [get_nets ps_i/Counter_Core_0/inst/clk_fx_ibuf]
set_property PACKAGE_PIN B19 [get_ports clk_fx_p]
set_property IOSTANDARD LVDS_25 [get_ports clk_fx_p]

#-----------------------------------------------------------------------------
# External 10 MHz reference clk_10m
#-----------------------------------------------------------------------------
set_property -dict {PACKAGE_PIN V5 IOSTANDARD LVCMOS33} [get_ports clk_10m]

#-----------------------------------------------------------------------------
# Control outputs
#-----------------------------------------------------------------------------
set_property -dict {PACKAGE_PIN W15 IOSTANDARD LVCMOS33} [get_ports CTR_PRIREF]
set_property -dict {PACKAGE_PIN V16 IOSTANDARD LVCMOS33} [get_ports CTR_REF_CLOCK]
set_property -dict {PACKAGE_PIN W16 IOSTANDARD LVCMOS33} [get_ports CTR_OCXO]

#-----------------------------------------------------------------------------
# Status inputs
#-----------------------------------------------------------------------------
set_property -dict {PACKAGE_PIN W14 IOSTANDARD LVCMOS33} [get_ports CTR_STATUS0]
set_property -dict {PACKAGE_PIN W13 IOSTANDARD LVCMOS33} [get_ports CTR_STATUS1]
set_property -dict {PACKAGE_PIN J14 IOSTANDARD LVCMOS25} [get_ports CTR_START_T]
