Han-ZenX/CounterCode/top_cymometer.sdk/ps_wrapper_hw_platform_0/drivers/Counter_v1_0/src/Counter.h

#ifndef COUNTER_H
#define COUNTER_H


/****************** Include Files ********************/
#include "xil_types.h"
#include "xstatus.h"

#define COUNTER_S_AXI_SLV_REG0_OFFSET 0
#define COUNTER_S_AXI_SLV_REG1_OFFSET 4
#define COUNTER_S_AXI_SLV_REG2_OFFSET 8
#define COUNTER_S_AXI_SLV_REG3_OFFSET 12
#define COUNTER_S_AXI_SLV_REG4_OFFSET 16
#define COUNTER_S_AXI_SLV_REG5_OFFSET 20
#define COUNTER_S_AXI_SLV_REG6_OFFSET 24
#define COUNTER_S_AXI_SLV_REG7_OFFSET 28
#define COUNTER_S_AXI_SLV_REG8_OFFSET 32
#define COUNTER_S_AXI_SLV_REG9_OFFSET 36
#define COUNTER_S_AXI_SLV_REG10_OFFSET 40
#define COUNTER_S_AXI_SLV_REG11_OFFSET 44
#define COUNTER_S_AXI_SLV_REG12_OFFSET 48
#define COUNTER_S_AXI_SLV_REG13_OFFSET 52
#define COUNTER_S_AXI_SLV_REG14_OFFSET 56
#define COUNTER_S_AXI_SLV_REG15_OFFSET 60
#define COUNTER_S_AXI_SLV_REG16_OFFSET 64
#define COUNTER_S_AXI_SLV_REG17_OFFSET 68
#define COUNTER_S_AXI_SLV_REG18_OFFSET 72
#define COUNTER_S_AXI_SLV_REG19_OFFSET 76
#define COUNTER_S_AXI_SLV_REG20_OFFSET 80
#define COUNTER_S_AXI_SLV_REG21_OFFSET 84
#define COUNTER_S_AXI_SLV_REG22_OFFSET 88
#define COUNTER_S_AXI_SLV_REG23_OFFSET 92
#define COUNTER_S_AXI_SLV_REG24_OFFSET 96
#define COUNTER_S_AXI_SLV_REG25_OFFSET 100
#define COUNTER_S_AXI_SLV_REG26_OFFSET 104
#define COUNTER_S_AXI_SLV_REG27_OFFSET 108
#define COUNTER_S_AXI_SLV_REG28_OFFSET 112
#define COUNTER_S_AXI_SLV_REG29_OFFSET 116
#define COUNTER_S_AXI_SLV_REG30_OFFSET 120
#define COUNTER_S_AXI_SLV_REG31_OFFSET 124
#define COUNTER_S_AXI_SLV_REG32_OFFSET 128
#define COUNTER_S_AXI_SLV_REG33_OFFSET 132
#define COUNTER_S_AXI_SLV_REG34_OFFSET 136
#define COUNTER_S_AXI_SLV_REG35_OFFSET 140
#define COUNTER_S_AXI_SLV_REG36_OFFSET 144
#define COUNTER_S_AXI_SLV_REG37_OFFSET 148
#define COUNTER_S_AXI_SLV_REG38_OFFSET 152
#define COUNTER_S_AXI_SLV_REG39_OFFSET 156
#define COUNTER_S_AXI_SLV_REG40_OFFSET 160
#define COUNTER_S_AXI_SLV_REG41_OFFSET 164
#define COUNTER_S_AXI_SLV_REG42_OFFSET 168
#define COUNTER_S_AXI_SLV_REG43_OFFSET 172
#define COUNTER_S_AXI_SLV_REG44_OFFSET 176
#define COUNTER_S_AXI_SLV_REG45_OFFSET 180
#define COUNTER_S_AXI_SLV_REG46_OFFSET 184
#define COUNTER_S_AXI_SLV_REG47_OFFSET 188
#define COUNTER_S_AXI_SLV_REG48_OFFSET 192
#define COUNTER_S_AXI_SLV_REG49_OFFSET 196
#define COUNTER_S_AXI_SLV_REG50_OFFSET 200
#define COUNTER_S_AXI_SLV_REG51_OFFSET 204
#define COUNTER_S_AXI_SLV_REG52_OFFSET 208
#define COUNTER_S_AXI_SLV_REG53_OFFSET 212
#define COUNTER_S_AXI_SLV_REG54_OFFSET 216
#define COUNTER_S_AXI_SLV_REG55_OFFSET 220
#define COUNTER_S_AXI_SLV_REG56_OFFSET 224
#define COUNTER_S_AXI_SLV_REG57_OFFSET 228
#define COUNTER_S_AXI_SLV_REG58_OFFSET 232
#define COUNTER_S_AXI_SLV_REG59_OFFSET 236
#define COUNTER_S_AXI_SLV_REG60_OFFSET 240
#define COUNTER_S_AXI_SLV_REG61_OFFSET 244
#define COUNTER_S_AXI_SLV_REG62_OFFSET 248
#define COUNTER_S_AXI_SLV_REG63_OFFSET 252
#define COUNTER_S_AXI_SLV_REG64_OFFSET 256
#define COUNTER_S_AXI_SLV_REG65_OFFSET 260
#define COUNTER_S_AXI_SLV_REG66_OFFSET 264
#define COUNTER_S_AXI_SLV_REG67_OFFSET 268
#define COUNTER_S_AXI_SLV_REG68_OFFSET 272
#define COUNTER_S_AXI_SLV_REG69_OFFSET 276
#define COUNTER_S_AXI_SLV_REG70_OFFSET 280
#define COUNTER_S_AXI_SLV_REG71_OFFSET 284
#define COUNTER_S_AXI_SLV_REG72_OFFSET 288
#define COUNTER_S_AXI_SLV_REG73_OFFSET 292
#define COUNTER_S_AXI_SLV_REG74_OFFSET 296
#define COUNTER_S_AXI_SLV_REG75_OFFSET 300
#define COUNTER_S_AXI_SLV_REG76_OFFSET 304
#define COUNTER_S_AXI_SLV_REG77_OFFSET 308
#define COUNTER_S_AXI_SLV_REG78_OFFSET 312
#define COUNTER_S_AXI_SLV_REG79_OFFSET 316
#define COUNTER_S_AXI_SLV_REG80_OFFSET 320
#define COUNTER_S_AXI_SLV_REG81_OFFSET 324
#define COUNTER_S_AXI_SLV_REG82_OFFSET 328
#define COUNTER_S_AXI_SLV_REG83_OFFSET 332
#define COUNTER_S_AXI_SLV_REG84_OFFSET 336
#define COUNTER_S_AXI_SLV_REG85_OFFSET 340
#define COUNTER_S_AXI_SLV_REG86_OFFSET 344
#define COUNTER_S_AXI_SLV_REG87_OFFSET 348
#define COUNTER_S_AXI_SLV_REG88_OFFSET 352
#define COUNTER_S_AXI_SLV_REG89_OFFSET 356
#define COUNTER_S_AXI_SLV_REG90_OFFSET 360
#define COUNTER_S_AXI_SLV_REG91_OFFSET 364
#define COUNTER_S_AXI_SLV_REG92_OFFSET 368
#define COUNTER_S_AXI_SLV_REG93_OFFSET 372
#define COUNTER_S_AXI_SLV_REG94_OFFSET 376
#define COUNTER_S_AXI_SLV_REG95_OFFSET 380
#define COUNTER_S_AXI_SLV_REG96_OFFSET 384
#define COUNTER_S_AXI_SLV_REG97_OFFSET 388
#define COUNTER_S_AXI_SLV_REG98_OFFSET 392
#define COUNTER_S_AXI_SLV_REG99_OFFSET 396


/**************************** Type Definitions *****************************/
/**
 *
 * Write a value to a COUNTER register. A 32 bit write is performed.
 * If the component is implemented in a smaller width, only the least
 * significant data is written.
 *
 * @param   BaseAddress is the base address of the COUNTERdevice.
 * @param   RegOffset is the register offset from the base to write to.
 * @param   Data is the data written to the register.
 *
 * @return  None.
 *
 * @note
 * C-style signature:
 * 	void COUNTER_mWriteReg(u32 BaseAddress, unsigned RegOffset, u32 Data)
 *
 */
#define COUNTER_mWriteReg(BaseAddress, RegOffset, Data) \
  	Xil_Out32((BaseAddress) + (RegOffset), (u32)(Data))

/**
 *
 * Read a value from a COUNTER register. A 32 bit read is performed.
 * If the component is implemented in a smaller width, only the least
 * significant data is read from the register. The most significant data
 * will be read as 0.
 *
 * @param   BaseAddress is the base address of the COUNTER device.
 * @param   RegOffset is the register offset from the base to write to.
 *
 * @return  Data is the data from the register.
 *
 * @note
 * C-style signature:
 * 	u32 COUNTER_mReadReg(u32 BaseAddress, unsigned RegOffset)
 *
 */
#define COUNTER_mReadReg(BaseAddress, RegOffset) \
    Xil_In32((BaseAddress) + (RegOffset))

/************************** Function Prototypes ****************************/
/**
 *
 * Run a self-test on the driver/device. Note this may be a destructive test if
 * resets of the device are performed.
 *
 * If the hardware system is not built correctly, this function may never
 * return to the caller.
 *
 * @param   baseaddr_p is the base address of the COUNTER instance to be worked on.
 *
 * @return
 *
 *    - XST_SUCCESS   if all self-test code passed
 *    - XST_FAILURE   if any self-test code failed
 *
 * @note    Caching must be turned off for this function to work.
 * @note    Self test may fail if data memory and device are not on the same bus.
 *
 */
XStatus COUNTER_Reg_SelfTest(void * baseaddr_p);

#endif // COUNTER_H
