Han-ZenX/CounterCode/ip_repo/Counter_Sig/Counter_Sig_1.0/drivers/Counter_Sig_v1_0/src/Counter_Sig.h

#ifndef COUNTER_SIG_H
#define COUNTER_SIG_H


/****************** Include Files ********************/
#include "xil_types.h"
#include "xstatus.h"

#define COUNTER_SIG_S_AXI_SLV_REG0_OFFSET 0
#define COUNTER_SIG_S_AXI_SLV_REG1_OFFSET 4
#define COUNTER_SIG_S_AXI_SLV_REG2_OFFSET 8
#define COUNTER_SIG_S_AXI_SLV_REG3_OFFSET 12
#define COUNTER_SIG_S_AXI_SLV_REG4_OFFSET 16
#define COUNTER_SIG_S_AXI_SLV_REG5_OFFSET 20
#define COUNTER_SIG_S_AXI_SLV_REG6_OFFSET 24
#define COUNTER_SIG_S_AXI_SLV_REG7_OFFSET 28
#define COUNTER_SIG_S_AXI_SLV_REG8_OFFSET 32
#define COUNTER_SIG_S_AXI_SLV_REG9_OFFSET 36
#define COUNTER_SIG_S_AXI_SLV_REG10_OFFSET 40
#define COUNTER_SIG_S_AXI_SLV_REG11_OFFSET 44
#define COUNTER_SIG_S_AXI_SLV_REG12_OFFSET 48
#define COUNTER_SIG_S_AXI_SLV_REG13_OFFSET 52
#define COUNTER_SIG_S_AXI_SLV_REG14_OFFSET 56
#define COUNTER_SIG_S_AXI_SLV_REG15_OFFSET 60
#define COUNTER_SIG_S_AXI_SLV_REG16_OFFSET 64
#define COUNTER_SIG_S_AXI_SLV_REG17_OFFSET 68
#define COUNTER_SIG_S_AXI_SLV_REG18_OFFSET 72
#define COUNTER_SIG_S_AXI_SLV_REG19_OFFSET 76
#define COUNTER_SIG_S_AXI_SLV_REG20_OFFSET 80
#define COUNTER_SIG_S_AXI_SLV_REG21_OFFSET 84
#define COUNTER_SIG_S_AXI_SLV_REG22_OFFSET 88
#define COUNTER_SIG_S_AXI_SLV_REG23_OFFSET 92
#define COUNTER_SIG_S_AXI_SLV_REG24_OFFSET 96
#define COUNTER_SIG_S_AXI_SLV_REG25_OFFSET 100
#define COUNTER_SIG_S_AXI_SLV_REG26_OFFSET 104
#define COUNTER_SIG_S_AXI_SLV_REG27_OFFSET 108
#define COUNTER_SIG_S_AXI_SLV_REG28_OFFSET 112
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
 *
 * @return  None.
 *
 * @note
 * C-style signature:
 * 	void COUNTER_SIG_mWriteReg(u32 BaseAddress, unsigned RegOffset, u32 Data)
 *
 */
#define COUNTER_SIG_mWriteReg(BaseAddress, RegOffset, Data) \
  	Xil_Out32((BaseAddress) + (RegOffset), (u32)(Data))

/**
 *
 * Read a value from a COUNTER_SIG register. A 32 bit read is performed.
 * If the component is implemented in a smaller width, only the least
 * significant data is read from the register. The most significant data
 * will be read as 0.
 *
 * @param   BaseAddress is the base address of the COUNTER_SIG device.
 * @param   RegOffset is the register offset from the base to write to.
 *
 * @return  Data is the data from the register.
 *
 * @note
 * C-style signature:
 * 	u32 COUNTER_SIG_mReadReg(u32 BaseAddress, unsigned RegOffset)
 *
 */
#define COUNTER_SIG_mReadReg(BaseAddress, RegOffset) \
    Xil_In32((BaseAddress) + (RegOffset))

/************************** Function Prototypes ****************************/
/**
 *
 * Run a self-test on the driver/device. Note this may be a destructive test if
 * resets of the device are performed.
 *
 * If the hardware system is not built correctly, this function may never
 * return to the caller.
 *
 * @param   baseaddr_p is the base address of the COUNTER_SIG instance to be worked on.
 *
 * @return
 *
 *    - XST_SUCCESS   if all self-test code passed
 *    - XST_FAILURE   if any self-test code failed
 *
 * @note    Caching must be turned off for this function to work.
 * @note    Self test may fail if data memory and device are not on the same bus.
 *
 */
XStatus COUNTER_SIG_Reg_SelfTest(void * baseaddr_p);

#endif // COUNTER_SIG_H
