Han-ZenX/CounterCode/top_cymometer.srcs/sources_1/bd/ps/ip/ps_Counter_Core_0_0/synth/ps_Counter_Core_0_0.v

// (c) Copyright 1995-2026 Xilinx, Inc. All rights reserved.
// 
// This file contains confidential and proprietary information
// of Xilinx, Inc. and is protected under U.S. and
// international copyright and other intellectual property
// laws.
// 
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
// CRITICAL APPLICATIONS
// Xilinx products are not designed or intended to be fail-
// safe, or for use in any application requiring fail-safe
// performance, such as life-support or safety devices or
// systems, Class III medical devices, nuclear facilities,
// applications related to the deployment of airbags, or any
// other applications that could lead to death, personal
// injury, or severe property or environmental damage
// (individually and collectively, "Critical
// Applications"). Customer assumes the sole risk and
// liability of any use of Xilinx products in Critical
// Applications, subject only to applicable laws and
// regulations governing limitations on product liability.
// 
// THIS COPYRIGHT NOTICE AND DISCLAIMER MUST BE RETAINED AS
// PART OF THIS FILE AT ALL TIMES.
// 
// DO NOT MODIFY THIS FILE.


// IP VLNV: xilinx.com:user:Counter_Core:1.0
// IP Revision: 16

(* X_CORE_INFO = "Counter_Core_v1_0,Vivado 2018.3" *)
(* CHECK_LICENSE_TYPE = "ps_Counter_Core_0_0,Counter_Core_v1_0,{}" *)
(* CORE_GENERATION_INFO = "ps_Counter_Core_0_0,Counter_Core_v1_0,{x_ipProduct=Vivado 2018.3,x_ipVendor=xilinx.com,x_ipLibrary=user,x_ipName=Counter_Core,x_ipVersion=1.0,x_ipCoreRevision=16,x_ipLanguage=VERILOG,x_ipSimLanguage=MIXED,C_M_AXIS_TDATA_WIDTH=64,C_M_AXIS_START_COUNT=32,C_S_AXI_DATA_WIDTH=32,C_S_AXI_ADDR_WIDTH=8,FIFO_ADDR_WIDTH=12,NUM_TAPS=256}" *)
(* DowngradeIPIdentifiedWarnings = "yes" *)
module ps_Counter_Core_0_0 (
  clk_fs_p,
  clk_fs_n,
  clk_fx_p,
  clk_fx_n,
  clk_10m,
  stream_aresetn,
  m_axis_tdata,
  m_axis_tstrb,
  m_axis_tlast,
  m_axis_tvalid,
  m_axis_tready,
  m_axis_aclk,
  m_axis_aresetn,
  s_axi_awaddr,
  s_axi_awprot,
  s_axi_awvalid,
  s_axi_awready,
  s_axi_wdata,
  s_axi_wstrb,
  s_axi_wvalid,
  s_axi_wready,
  s_axi_bresp,
  s_axi_bvalid,
  s_axi_bready,
  s_axi_araddr,
  s_axi_arprot,
  s_axi_arvalid,
  s_axi_arready,
  s_axi_rdata,
  s_axi_rresp,
  s_axi_rvalid,
  s_axi_rready,
  s_axi_aclk,
  s_axi_aresetn
);

input wire clk_fs_p;
input wire clk_fs_n;
input wire clk_fx_p;
input wire clk_fx_n;
input wire clk_10m;
(* X_INTERFACE_PARAMETER = "XIL_INTERFACENAME stream_aresetn, POLARITY ACTIVE_LOW, INSERT_VIP 0" *)
(* X_INTERFACE_INFO = "xilinx.com:signal:reset:1.0 stream_aresetn RST" *)
output wire stream_aresetn;
(* X_INTERFACE_INFO = "xilinx.com:interface:axis:1.0 M_AXIS TDATA" *)
output wire [63 : 0] m_axis_tdata;
(* X_INTERFACE_INFO = "xilinx.com:interface:axis:1.0 M_AXIS TSTRB" *)
output wire [7 : 0] m_axis_tstrb;
(* X_INTERFACE_INFO = "xilinx.com:interface:axis:1.0 M_AXIS TLAST" *)
output wire m_axis_tlast;
(* X_INTERFACE_INFO = "xilinx.com:interface:axis:1.0 M_AXIS TVALID" *)
output wire m_axis_tvalid;
(* X_INTERFACE_PARAMETER = "XIL_INTERFACENAME M_AXIS, WIZ_DATA_WIDTH 32, TDATA_NUM_BYTES 8, TDEST_WIDTH 0, TID_WIDTH 0, TUSER_WIDTH 0, HAS_TREADY 1, HAS_TSTRB 1, HAS_TKEEP 0, HAS_TLAST 1, FREQ_HZ 100000000, PHASE 0.000, CLK_DOMAIN ps_processing_system7_0_0_FCLK_CLK0, LAYERED_METADATA undef, INSERT_VIP 0" *)
(* X_INTERFACE_INFO = "xilinx.com:interface:axis:1.0 M_AXIS TREADY" *)
input wire m_axis_tready;
(* X_INTERFACE_PARAMETER = "XIL_INTERFACENAME M_AXIS_CLK, ASSOCIATED_BUSIF M_AXIS, ASSOCIATED_RESET m_axis_aresetn, FREQ_HZ 100000000, PHASE 0.000, CLK_DOMAIN ps_processing_system7_0_0_FCLK_CLK0, INSERT_VIP 0" *)
(* X_INTERFACE_INFO = "xilinx.com:signal:clock:1.0 M_AXIS_CLK CLK" *)
input wire m_axis_aclk;
(* X_INTERFACE_PARAMETER = "XIL_INTERFACENAME M_AXIS_RST, POLARITY ACTIVE_LOW, INSERT_VIP 0" *)
(* X_INTERFACE_INFO = "xilinx.com:signal:reset:1.0 M_AXIS_RST RST" *)
input wire m_axis_aresetn;
(* X_INTERFACE_INFO = "xilinx.com:interface:aximm:1.0 S_AXI AWADDR" *)
input wire [7 : 0] s_axi_awaddr;
(* X_INTERFACE_INFO = "xilinx.com:interface:aximm:1.0 S_AXI AWPROT" *)
input wire [2 : 0] s_axi_awprot;
(* X_INTERFACE_INFO = "xilinx.com:interface:aximm:1.0 S_AXI AWVALID" *)
input wire s_axi_awvalid;
(* X_INTERFACE_INFO = "xilinx.com:interface:aximm:1.0 S_AXI AWREADY" *)
output wire s_axi_awready;
(* X_INTERFACE_INFO = "xilinx.com:interface:aximm:1.0 S_AXI WDATA" *)
input wire [31 : 0] s_axi_wdata;
(* X_INTERFACE_INFO = "xilinx.com:interface:aximm:1.0 S_AXI WSTRB" *)
input wire [3 : 0] s_axi_wstrb;
(* X_INTERFACE_INFO = "xilinx.com:interface:aximm:1.0 S_AXI WVALID" *)
input wire s_axi_wvalid;
(* X_INTERFACE_INFO = "xilinx.com:interface:aximm:1.0 S_AXI WREADY" *)
output wire s_axi_wready;
(* X_INTERFACE_INFO = "xilinx.com:interface:aximm:1.0 S_AXI BRESP" *)
output wire [1 : 0] s_axi_bresp;
(* X_INTERFACE_INFO = "xilinx.com:interface:aximm:1.0 S_AXI BVALID" *)
output wire s_axi_bvalid;
(* X_INTERFACE_INFO = "xilinx.com:interface:aximm:1.0 S_AXI BREADY" *)
input wire s_axi_bready;
(* X_INTERFACE_INFO = "xilinx.com:interface:aximm:1.0 S_AXI ARADDR" *)
input wire [7 : 0] s_axi_araddr;
(* X_INTERFACE_INFO = "xilinx.com:interface:aximm:1.0 S_AXI ARPROT" *)
input wire [2 : 0] s_axi_arprot;
(* X_INTERFACE_INFO = "xilinx.com:interface:aximm:1.0 S_AXI ARVALID" *)
input wire s_axi_arvalid;
(* X_INTERFACE_INFO = "xilinx.com:interface:aximm:1.0 S_AXI ARREADY" *)
output wire s_axi_arready;
(* X_INTERFACE_INFO = "xilinx.com:interface:aximm:1.0 S_AXI RDATA" *)
output wire [31 : 0] s_axi_rdata;
(* X_INTERFACE_INFO = "xilinx.com:interface:aximm:1.0 S_AXI RRESP" *)
output wire [1 : 0] s_axi_rresp;
(* X_INTERFACE_INFO = "xilinx.com:interface:aximm:1.0 S_AXI RVALID" *)
output wire s_axi_rvalid;
(* X_INTERFACE_PARAMETER = "XIL_INTERFACENAME S_AXI, WIZ_DATA_WIDTH 32, WIZ_NUM_REG 50, SUPPORTS_NARROW_BURST 0, DATA_WIDTH 32, PROTOCOL AXI4LITE, FREQ_HZ 100000000, ID_WIDTH 0, ADDR_WIDTH 8, AWUSER_WIDTH 0, ARUSER_WIDTH 0, WUSER_WIDTH 0, RUSER_WIDTH 0, BUSER_WIDTH 0, READ_WRITE_MODE READ_WRITE, HAS_BURST 0, HAS_LOCK 0, HAS_PROT 1, HAS_CACHE 0, HAS_QOS 0, HAS_REGION 0, HAS_WSTRB 1, HAS_BRESP 1, HAS_RRESP 1, NUM_READ_OUTSTANDING 2, NUM_WRITE_OUTSTANDING 2, MAX_BURST_LENGTH 1, PHASE 0.000, CLK_DOMAIN ps_processing_system7_0_\
0_FCLK_CLK0, NUM_READ_THREADS 1, NUM_WRITE_THREADS 1, RUSER_BITS_PER_BYTE 0, WUSER_BITS_PER_BYTE 0, INSERT_VIP 0" *)
(* X_INTERFACE_INFO = "xilinx.com:interface:aximm:1.0 S_AXI RREADY" *)
input wire s_axi_rready;
(* X_INTERFACE_PARAMETER = "XIL_INTERFACENAME S_AXI_CLK, ASSOCIATED_BUSIF S_AXI, ASSOCIATED_RESET s_axi_aresetn, FREQ_HZ 100000000, PHASE 0.000, CLK_DOMAIN ps_processing_system7_0_0_FCLK_CLK0, INSERT_VIP 0" *)
(* X_INTERFACE_INFO = "xilinx.com:signal:clock:1.0 S_AXI_CLK CLK" *)
input wire s_axi_aclk;
(* X_INTERFACE_PARAMETER = "XIL_INTERFACENAME S_AXI_RST, POLARITY ACTIVE_LOW, INSERT_VIP 0" *)
(* X_INTERFACE_INFO = "xilinx.com:signal:reset:1.0 S_AXI_RST RST" *)
input wire s_axi_aresetn;

  Counter_Core_v1_0 #(
    .C_M_AXIS_TDATA_WIDTH(64),  // Width of S_AXIS address bus. The slave accepts the read and write addresses of width C_M_AXIS_TDATA_WIDTH.
    .C_M_AXIS_START_COUNT(32),  // Start count is the number of clock cycles the master will wait before initiating/issuing any transaction.
    .C_S_AXI_DATA_WIDTH(32),  // Width of S_AXI data bus
    .C_S_AXI_ADDR_WIDTH(8),  // Width of S_AXI address bus
    .FIFO_ADDR_WIDTH(12),
    .NUM_TAPS(256)
  ) inst (
    .clk_fs_p(clk_fs_p),
    .clk_fs_n(clk_fs_n),
    .clk_fx_p(clk_fx_p),
    .clk_fx_n(clk_fx_n),
    .clk_10m(clk_10m),
    .stream_aresetn(stream_aresetn),
    .m_axis_tdata(m_axis_tdata),
    .m_axis_tstrb(m_axis_tstrb),
    .m_axis_tlast(m_axis_tlast),
    .m_axis_tvalid(m_axis_tvalid),
    .m_axis_tready(m_axis_tready),
    .m_axis_aclk(m_axis_aclk),
    .m_axis_aresetn(m_axis_aresetn),
    .s_axi_awaddr(s_axi_awaddr),
    .s_axi_awprot(s_axi_awprot),
    .s_axi_awvalid(s_axi_awvalid),
    .s_axi_awready(s_axi_awready),
    .s_axi_wdata(s_axi_wdata),
    .s_axi_wstrb(s_axi_wstrb),
    .s_axi_wvalid(s_axi_wvalid),
    .s_axi_wready(s_axi_wready),
    .s_axi_bresp(s_axi_bresp),
    .s_axi_bvalid(s_axi_bvalid),
    .s_axi_bready(s_axi_bready),
    .s_axi_araddr(s_axi_araddr),
    .s_axi_arprot(s_axi_arprot),
    .s_axi_arvalid(s_axi_arvalid),
    .s_axi_arready(s_axi_arready),
    .s_axi_rdata(s_axi_rdata),
    .s_axi_rresp(s_axi_rresp),
    .s_axi_rvalid(s_axi_rvalid),
    .s_axi_rready(s_axi_rready),
    .s_axi_aclk(s_axi_aclk),
    .s_axi_aresetn(s_axi_aresetn)
  );
endmodule
