Han-ZenX/CounterCode/top_cymometer.srcs/sources_1/bd/ps/ip/ps_axi_smc_0/bd_0/ip/ip_10/synth/bd_af51_m00e_0.sv

// (c) Copyright 1995-2026 Xilinx, Inc. All rights reserved.
// 
// This file contains confidential and proprietary information
// of Xilinx, Inc. and is protected under U.S. and
// international copyright and other intellectual property
// laws.
// 
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
// CRITICAL APPLICATIONS
// Xilinx products are not designed or intended to be fail-
// safe, or for use in any application requiring fail-safe
// performance, such as life-support or safety devices or
// systems, Class III medical devices, nuclear facilities,
// applications related to the deployment of airbags, or any
// other applications that could lead to death, personal
// injury, or severe property or environmental damage
// (individually and collectively, "Critical
// Applications"). Customer assumes the sole risk and
// liability of any use of Xilinx products in Critical
// Applications, subject only to applicable laws and
// regulations governing limitations on product liability.
// 
// THIS COPYRIGHT NOTICE AND DISCLAIMER MUST BE RETAINED AS
// PART OF THIS FILE AT ALL TIMES.
// 
// DO NOT MODIFY THIS FILE.


// IP VLNV: xilinx.com:ip:sc_exit:1.0
// IP Revision: 8

(* X_CORE_INFO = "sc_exit_v1_0_8_top,Vivado 2018.3" *)
(* CHECK_LICENSE_TYPE = "bd_af51_m00e_0,sc_exit_v1_0_8_top,{}" *)
(* CORE_GENERATION_INFO = "bd_af51_m00e_0,sc_exit_v1_0_8_top,{x_ipProduct=Vivado 2018.3,x_ipVendor=xilinx.com,x_ipLibrary=ip,x_ipName=sc_exit,x_ipVersion=1.0,x_ipCoreRevision=8,x_ipLanguage=VERILOG,x_ipSimLanguage=MIXED,C_FAMILY=zynq,C_ENABLE_PIPELINING=0x1,C_IS_CASCADED=0,C_SSC_ROUTE_WIDTH=1,C_MEP_IDENTIFIER_WIDTH=1,C_SSC_ROUTE_ARRAY=0b01,C_RDATA_WIDTH=64,C_WDATA_WIDTH=64,C_M_RUSER_BITS_PER_BYTE=0,C_M_WUSER_BITS_PER_BYTE=0,C_MAX_RUSER_BITS_PER_BYTE=0,C_MAX_WUSER_BITS_PER_BYTE=0,C_M_ARUSER_WIDTH=0,C_M_AWUSER_WIDTH=0,C_M_R\
USER_WIDTH=0,C_M_WUSER_WIDTH=0,C_M_BUSER_WIDTH=0,C_S_ID_WIDTH=1,C_M_ID_WIDTH=0,C_ADDR_WIDTH=32,C_M_PROTOCOL=1,C_HAS_LOCK=0,C_NUM_MSC=1,C_SINGLE_ISSUING=0,C_M_LIMIT_READ_LENGTH=16,C_M_LIMIT_WRITE_LENGTH=16,C_NUM_READ_OUTSTANDING=2,C_NUM_WRITE_OUTSTANDING=16,C_READ_ACCEPTANCE=32,C_WRITE_ACCEPTANCE=32}" *)
(* DowngradeIPIdentifiedWarnings = "yes" *)
module bd_af51_m00e_0 (
  aclk,
  aresetn,
  s_axi_awid,
  s_axi_awaddr,
  s_axi_awlen,
  s_axi_awlock,
  s_axi_awcache,
  s_axi_awprot,
  s_axi_awqos,
  s_axi_awuser,
  s_axi_awvalid,
  s_axi_awready,
  s_axi_wdata,
  s_axi_wstrb,
  s_axi_wlast,
  s_axi_wuser,
  s_axi_wvalid,
  s_axi_wready,
  s_axi_bid,
  s_axi_bresp,
  s_axi_buser,
  s_axi_bvalid,
  s_axi_bready,
  m_axi_awaddr,
  m_axi_awlen,
  m_axi_awsize,
  m_axi_awburst,
  m_axi_awlock,
  m_axi_awcache,
  m_axi_awprot,
  m_axi_awqos,
  m_axi_awvalid,
  m_axi_awready,
  m_axi_wdata,
  m_axi_wstrb,
  m_axi_wlast,
  m_axi_wvalid,
  m_axi_wready,
  m_axi_bresp,
  m_axi_bvalid,
  m_axi_bready
);

(* X_INTERFACE_PARAMETER = "XIL_INTERFACENAME CLK, FREQ_HZ 100000000, PHASE 0.000, CLK_DOMAIN ps_processing_system7_0_0_FCLK_CLK0, ASSOCIATED_BUSIF S_AXI:M_AXI, ASSOCIATED_RESET aresetn, INSERT_VIP 0" *)
(* X_INTERFACE_INFO = "xilinx.com:signal:clock:1.0 CLK CLK" *)
input wire aclk;
(* X_INTERFACE_PARAMETER = "XIL_INTERFACENAME RST, POLARITY ACTIVE_LOW, INSERT_VIP 0, TYPE INTERCONNECT" *)
(* X_INTERFACE_INFO = "xilinx.com:signal:reset:1.0 RST RST" *)
input wire aresetn;
(* X_INTERFACE_INFO = "xilinx.com:interface:aximm:1.0 S_AXI AWID" *)
input wire [0 : 0] s_axi_awid;
(* X_INTERFACE_INFO = "xilinx.com:interface:aximm:1.0 S_AXI AWADDR" *)
input wire [31 : 0] s_axi_awaddr;
(* X_INTERFACE_INFO = "xilinx.com:interface:aximm:1.0 S_AXI AWLEN" *)
input wire [7 : 0] s_axi_awlen;
(* X_INTERFACE_INFO = "xilinx.com:interface:aximm:1.0 S_AXI AWLOCK" *)
input wire [0 : 0] s_axi_awlock;
(* X_INTERFACE_INFO = "xilinx.com:interface:aximm:1.0 S_AXI AWCACHE" *)
input wire [3 : 0] s_axi_awcache;
(* X_INTERFACE_INFO = "xilinx.com:interface:aximm:1.0 S_AXI AWPROT" *)
input wire [2 : 0] s_axi_awprot;
(* X_INTERFACE_INFO = "xilinx.com:interface:aximm:1.0 S_AXI AWQOS" *)
input wire [3 : 0] s_axi_awqos;
(* X_INTERFACE_INFO = "xilinx.com:interface:aximm:1.0 S_AXI AWUSER" *)
input wire [1023 : 0] s_axi_awuser;
(* X_INTERFACE_INFO = "xilinx.com:interface:aximm:1.0 S_AXI AWVALID" *)
input wire s_axi_awvalid;
(* X_INTERFACE_INFO = "xilinx.com:interface:aximm:1.0 S_AXI AWREADY" *)
output wire s_axi_awready;
(* X_INTERFACE_INFO = "xilinx.com:interface:aximm:1.0 S_AXI WDATA" *)
input wire [63 : 0] s_axi_wdata;
(* X_INTERFACE_INFO = "xilinx.com:interface:aximm:1.0 S_AXI WSTRB" *)
input wire [7 : 0] s_axi_wstrb;
(* X_INTERFACE_INFO = "xilinx.com:interface:aximm:1.0 S_AXI WLAST" *)
input wire s_axi_wlast;
(* X_INTERFACE_INFO = "xilinx.com:interface:aximm:1.0 S_AXI WUSER" *)
input wire [1023 : 0] s_axi_wuser;
(* X_INTERFACE_INFO = "xilinx.com:interface:aximm:1.0 S_AXI WVALID" *)
input wire s_axi_wvalid;
(* X_INTERFACE_INFO = "xilinx.com:interface:aximm:1.0 S_AXI WREADY" *)
output wire s_axi_wready;
(* X_INTERFACE_INFO = "xilinx.com:interface:aximm:1.0 S_AXI BID" *)
output wire [0 : 0] s_axi_bid;
(* X_INTERFACE_INFO = "xilinx.com:interface:aximm:1.0 S_AXI BRESP" *)
output wire [1 : 0] s_axi_bresp;
(* X_INTERFACE_INFO = "xilinx.com:interface:aximm:1.0 S_AXI BUSER" *)
output wire [1023 : 0] s_axi_buser;
(* X_INTERFACE_INFO = "xilinx.com:interface:aximm:1.0 S_AXI BVALID" *)
output wire s_axi_bvalid;
(* X_INTERFACE_PARAMETER = "XIL_INTERFACENAME S_AXI, DATA_WIDTH 64, PROTOCOL AXI4, FREQ_HZ 100000000, ID_WIDTH 1, ADDR_WIDTH 32, AWUSER_WIDTH 1024, ARUSER_WIDTH 0, WUSER_WIDTH 1024, RUSER_WIDTH 0, BUSER_WIDTH 1024, READ_WRITE_MODE WRITE_ONLY, HAS_BURST 0, HAS_LOCK 0, HAS_PROT 0, HAS_CACHE 0, HAS_QOS 0, HAS_REGION 0, HAS_WSTRB 1, HAS_BRESP 1, HAS_RRESP 0, SUPPORTS_NARROW_BURST 0, NUM_READ_OUTSTANDING 2, NUM_WRITE_OUTSTANDING 2, MAX_BURST_LENGTH 256, PHASE 0.000, CLK_DOMAIN ps_processing_system7_0_0_FCLK_CLK0, NUM_READ_THREA\
DS 1, NUM_WRITE_THREADS 1, RUSER_BITS_PER_BYTE 0, WUSER_BITS_PER_BYTE 0, INSERT_VIP 0" *)
(* X_INTERFACE_INFO = "xilinx.com:interface:aximm:1.0 S_AXI BREADY" *)
input wire s_axi_bready;
(* X_INTERFACE_INFO = "xilinx.com:interface:aximm:1.0 M_AXI AWADDR" *)
output wire [31 : 0] m_axi_awaddr;
(* X_INTERFACE_INFO = "xilinx.com:interface:aximm:1.0 M_AXI AWLEN" *)
output wire [3 : 0] m_axi_awlen;
(* X_INTERFACE_INFO = "xilinx.com:interface:aximm:1.0 M_AXI AWSIZE" *)
output wire [2 : 0] m_axi_awsize;
(* X_INTERFACE_INFO = "xilinx.com:interface:aximm:1.0 M_AXI AWBURST" *)
output wire [1 : 0] m_axi_awburst;
(* X_INTERFACE_INFO = "xilinx.com:interface:aximm:1.0 M_AXI AWLOCK" *)
output wire [1 : 0] m_axi_awlock;
(* X_INTERFACE_INFO = "xilinx.com:interface:aximm:1.0 M_AXI AWCACHE" *)
output wire [3 : 0] m_axi_awcache;
(* X_INTERFACE_INFO = "xilinx.com:interface:aximm:1.0 M_AXI AWPROT" *)
output wire [2 : 0] m_axi_awprot;
(* X_INTERFACE_INFO = "xilinx.com:interface:aximm:1.0 M_AXI AWQOS" *)
output wire [3 : 0] m_axi_awqos;
(* X_INTERFACE_INFO = "xilinx.com:interface:aximm:1.0 M_AXI AWVALID" *)
output wire m_axi_awvalid;
(* X_INTERFACE_INFO = "xilinx.com:interface:aximm:1.0 M_AXI AWREADY" *)
input wire m_axi_awready;
(* X_INTERFACE_INFO = "xilinx.com:interface:aximm:1.0 M_AXI WDATA" *)
output wire [63 : 0] m_axi_wdata;
(* X_INTERFACE_INFO = "xilinx.com:interface:aximm:1.0 M_AXI WSTRB" *)
output wire [7 : 0] m_axi_wstrb;
(* X_INTERFACE_INFO = "xilinx.com:interface:aximm:1.0 M_AXI WLAST" *)
output wire m_axi_wlast;
(* X_INTERFACE_INFO = "xilinx.com:interface:aximm:1.0 M_AXI WVALID" *)
output wire m_axi_wvalid;
(* X_INTERFACE_INFO = "xilinx.com:interface:aximm:1.0 M_AXI WREADY" *)
input wire m_axi_wready;
(* X_INTERFACE_INFO = "xilinx.com:interface:aximm:1.0 M_AXI BRESP" *)
input wire [1 : 0] m_axi_bresp;
(* X_INTERFACE_INFO = "xilinx.com:interface:aximm:1.0 M_AXI BVALID" *)
input wire m_axi_bvalid;
(* X_INTERFACE_PARAMETER = "XIL_INTERFACENAME M_AXI, DATA_WIDTH 64, PROTOCOL AXI3, FREQ_HZ 100000000, ID_WIDTH 0, ADDR_WIDTH 32, AWUSER_WIDTH 0, ARUSER_WIDTH 0, WUSER_WIDTH 0, RUSER_WIDTH 0, BUSER_WIDTH 0, READ_WRITE_MODE WRITE_ONLY, HAS_BURST 0, HAS_LOCK 0, HAS_PROT 0, HAS_CACHE 0, HAS_QOS 0, HAS_REGION 0, HAS_WSTRB 1, HAS_BRESP 1, HAS_RRESP 0, SUPPORTS_NARROW_BURST 0, NUM_READ_OUTSTANDING 2, NUM_WRITE_OUTSTANDING 16, MAX_BURST_LENGTH 16, PHASE 0.000, CLK_DOMAIN ps_processing_system7_0_0_FCLK_CLK0, NUM_READ_THREADS 1, NUM\
_WRITE_THREADS 1, RUSER_BITS_PER_BYTE 0, WUSER_BITS_PER_BYTE 0, INSERT_VIP 0" *)
(* X_INTERFACE_INFO = "xilinx.com:interface:aximm:1.0 M_AXI BREADY" *)
output wire m_axi_bready;

  sc_exit_v1_0_8_top #(
    .C_FAMILY("zynq"),
    .C_ENABLE_PIPELINING(1'H1),
    .C_IS_CASCADED(0),
    .C_SSC_ROUTE_WIDTH(1),
    .C_MEP_IDENTIFIER_WIDTH(1),
    .C_SSC_ROUTE_ARRAY(2'B01),
    .C_RDATA_WIDTH(64),
    .C_WDATA_WIDTH(64),
    .C_M_RUSER_BITS_PER_BYTE(0),
    .C_M_WUSER_BITS_PER_BYTE(0),
    .C_MAX_RUSER_BITS_PER_BYTE(0),
    .C_MAX_WUSER_BITS_PER_BYTE(0),
    .C_M_ARUSER_WIDTH(0),
    .C_M_AWUSER_WIDTH(0),
    .C_M_RUSER_WIDTH(0),
    .C_M_WUSER_WIDTH(0),
    .C_M_BUSER_WIDTH(0),
    .C_S_ID_WIDTH(1),
    .C_M_ID_WIDTH(0),
    .C_ADDR_WIDTH(32),
    .C_M_PROTOCOL(1),
    .C_HAS_LOCK(0),
    .C_NUM_MSC(1),
    .C_SINGLE_ISSUING(0),
    .C_M_LIMIT_READ_LENGTH(16),
    .C_M_LIMIT_WRITE_LENGTH(16),
    .C_NUM_READ_OUTSTANDING(2),
    .C_NUM_WRITE_OUTSTANDING(16),
    .C_READ_ACCEPTANCE(32),
    .C_WRITE_ACCEPTANCE(32)
  ) inst (
    .aclk(aclk),
    .aclken(1'B1),
    .aresetn(aresetn),
    .s_axi_awid(s_axi_awid),
    .s_axi_awaddr(s_axi_awaddr),
    .s_axi_awlen(s_axi_awlen),
    .s_axi_awlock(s_axi_awlock),
    .s_axi_awcache(s_axi_awcache),
    .s_axi_awprot(s_axi_awprot),
    .s_axi_awqos(s_axi_awqos),
    .s_axi_awuser(s_axi_awuser),
    .s_axi_awvalid(s_axi_awvalid),
    .s_axi_awready(s_axi_awready),
    .s_axi_wdata(s_axi_wdata),
    .s_axi_wstrb(s_axi_wstrb),
    .s_axi_wlast(s_axi_wlast),
    .s_axi_wuser(s_axi_wuser),
    .s_axi_wvalid(s_axi_wvalid),
    .s_axi_wready(s_axi_wready),
    .s_axi_bid(s_axi_bid),
    .s_axi_bresp(s_axi_bresp),
    .s_axi_buser(s_axi_buser),
    .s_axi_bvalid(s_axi_bvalid),
    .s_axi_bready(s_axi_bready),
    .s_axi_arid(1'H0),
    .s_axi_araddr(32'H00000000),
    .s_axi_arlen(8'H0),
    .s_axi_arlock(1'H0),
    .s_axi_arcache(4'H0),
    .s_axi_arprot(3'H0),
    .s_axi_arqos(4'H0),
    .s_axi_aruser(1024'H0),
    .s_axi_arvalid(1'H0),
    .s_axi_arready(),
    .s_axi_rid(),
    .s_axi_rdata(),
    .s_axi_rresp(),
    .s_axi_rlast(),
    .s_axi_ruser(),
    .s_axi_rvalid(),
    .s_axi_rready(1'H0),
    .m_axi_awid(),
    .m_axi_awaddr(m_axi_awaddr),
    .m_axi_awlen(m_axi_awlen),
    .m_axi_awsize(m_axi_awsize),
    .m_axi_awburst(m_axi_awburst),
    .m_axi_awlock(m_axi_awlock),
    .m_axi_awcache(m_axi_awcache),
    .m_axi_awprot(m_axi_awprot),
    .m_axi_awqos(m_axi_awqos),
    .m_axi_awuser(),
    .m_axi_awvalid(m_axi_awvalid),
    .m_axi_awready(m_axi_awready),
    .m_axi_wid(),
    .m_axi_wdata(m_axi_wdata),
    .m_axi_wstrb(m_axi_wstrb),
    .m_axi_wlast(m_axi_wlast),
    .m_axi_wuser(),
    .m_axi_wvalid(m_axi_wvalid),
    .m_axi_wready(m_axi_wready),
    .m_axi_bid(1'H0),
    .m_axi_bresp(m_axi_bresp),
    .m_axi_buser(1'H0),
    .m_axi_bvalid(m_axi_bvalid),
    .m_axi_bready(m_axi_bready),
    .m_axi_arid(),
    .m_axi_araddr(),
    .m_axi_arlen(),
    .m_axi_arsize(),
    .m_axi_arburst(),
    .m_axi_arlock(),
    .m_axi_arcache(),
    .m_axi_arprot(),
    .m_axi_arqos(),
    .m_axi_aruser(),
    .m_axi_arvalid(),
    .m_axi_arready(1'H0),
    .m_axi_rid(1'H0),
    .m_axi_rdata(64'H0000000000000000),
    .m_axi_rresp(2'H0),
    .m_axi_rlast(1'H1),
    .m_axi_ruser(1'H0),
    .m_axi_rvalid(1'H0),
    .m_axi_rready()
  );
endmodule
