Han-ZenX/CounterCode/(commit log)

2026-08-12 Initial commit: 高精度频率计项目 (FPGA-based High Precision Frequency Counter)
2026-08-20 add STARTUP:TRACE
